SleepWorkers/Project-SIGHT/README.md

# Introduction
This repository is created for the purpose of participation in [IICDC 2018](https://innovate.mygov.in/india-innovation-challenge-design-contest-2018/) (India Innovation Challenge Design Contest). The project details _in short_ are summarized below:

|||
| ----- | --- |
|**Project Name** | Project _SIGHT_ (Smart Infinity Glove using Heuristic Technology) - Transforming the way we live |
|**Submission ID** | 372888 |

# Table of contents
- [Introduction](#introduction)
- [Table of contents](#table-of-contents)
  - [About Project](#about-project)
- [Cloning this project](#cloning-this-project)
  - [Users](#users)
  - [Developers](#developers)
    - [Ubuntu users](#ubuntu-users)
    - [MacOS or Windows users](#macos-or-windows-users)
- [Folder information](#folder-information)
  - [Visible folders](#visible-folders)
  - [Hidden folders](#hidden-folders)

## About Project
This project is created for the purpose of participation in [IICDC 2018](https://innovate.mygov.in/india-innovation-challenge-design-contest-2018/) (India Innovation Challenge Design Contest).

The human hand is the most versatile part of the body. We exploit its dexterity to provide a glove that can transcend today’s wearables by giving an organic feel while interacting with technology. We feel today,the most important and difficult to procure resources are time, money, health & safety. S.I.G.H.T. will safeguard these resources.

We've used the following operating systems in the development of this project. Note that not all operating systems might support all packages of the project.
  - [Ubuntu Xenial](http://releases.ubuntu.com/16.04/)
  - [MacOS Mojave](https://www.apple.com/in/macos/mojave/)

The project proposal file can be found [here](./.media/docs/372888_IICDC\ Proposal.pdf).

# Cloning this project
If you're looking to contribute, you're a developer. If you're looking to only use the product, you're a user.
## Users
To clone (download) the project, you can simply click on the **Clone or Download** button in the top right and download the entire project as a ZIP file.
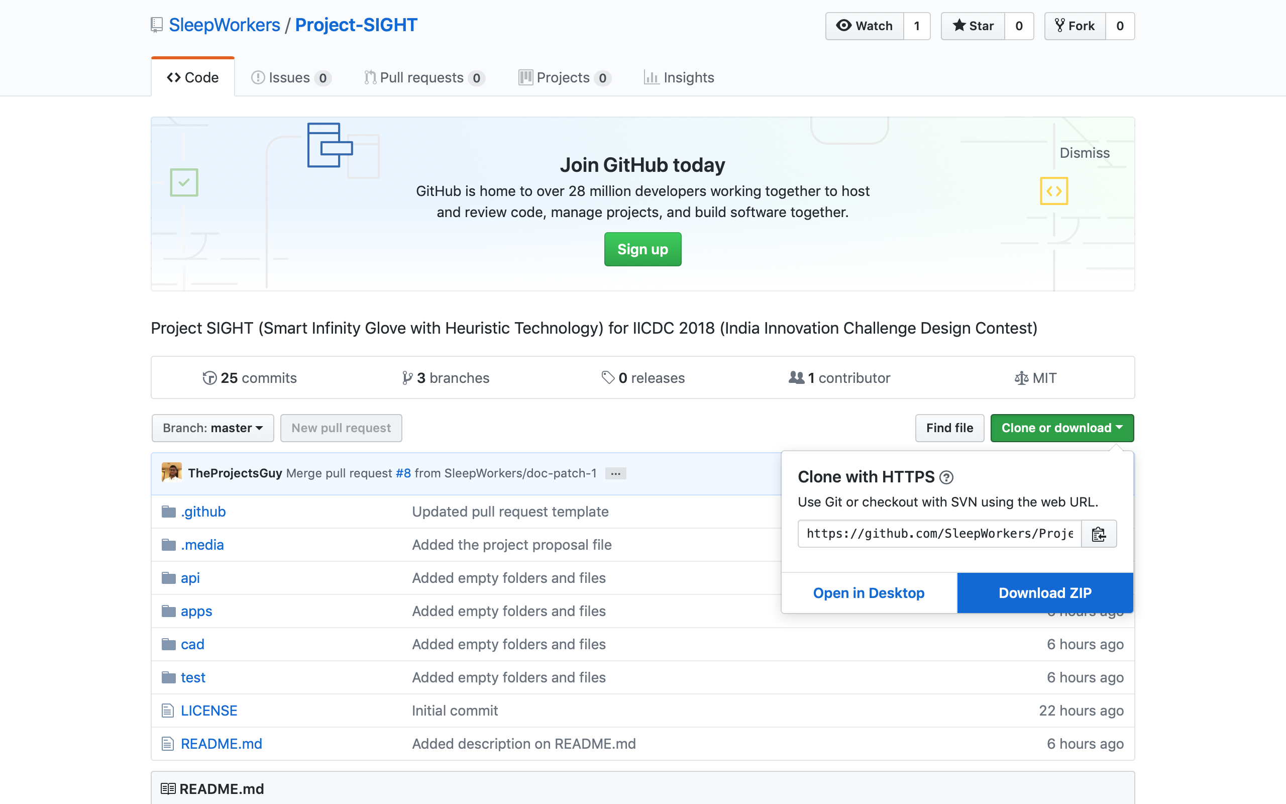
[picture p1: .media/photos/Download-project-ZIP.png]
Download as ZIP


## Developers
Before getting started, please go through the [contributing](./.github/CONTRIBUTING.md) guidelines.
You're suggested to clone this repository using the [git](https://git-scm.com/) tool which you can download [here](https://git-scm.com/downloads).
> **Tip**: Clone using [SSH](https://help.github.com/articles/connecting-to-github-with-ssh/) is a better idea.

### Ubuntu users
Open a terminal and do the following:
- _Install_ git
    ```bash
    sudo apt install git
    ```
- _cd_ into the directory where you want to clone
    ```bash
    cd ~
    ```
- _Clone_ the repository
  - Using SSH
    ```bash
    git clone git@github.com:SleepWorkers/Project-SIGHT.git
    ```
  - Using HTTPS
    ```bash
    git clone https://github.com/SleepWorkers/Project-SIGHT.git
    ```

### MacOS or Windows users
1. Install [GitHub Desktop](https://desktop.github.com) app.
2. Clone the repository (`File` -> `Clone Repository`) using the URL of this repository (https://github.com/SleepWorkers/Project-SIGHT.git) into a desired location.

You can use the GitHub Desktop app for all version control and project management purposes.

# Folder information
Here are the folders available in this project

## Visible folders

|||
|-----|-----|
|**test** | Files used during the testing phase |
|**cad**  | CAD files (Electrical and mechanical) |
|**api**  | Final APIs of the product |
|**apps** | Final applications for the product |

## Hidden folders
|||
|-----|-----|
|**.github**| All GitHub related documents.|
|**.media**| Media files used for documentation purposes in the present working directory.|
