SleepWorkers/Project-SIGHT/cad/README.md

# What is this ?
All the CAD files related to the SIGHT Project are stored in this folder.

# Table of Contents
- [What is this ?](#what-is-this)
- [Table of Contents](#table-of-contents)
