SleepWorkers/Project-SIGHT/(list of files, cad)

Other CAD files:
test/avneesh_test_files/TI_CC3220SF_WiFi_MCU/CCSv8_examples/I2CTest/tirtos_builds_CC3220SF_LAUNCHXL_release_ccs/src/sysbios/m3_IntrinsicsSupport_asm.obj
test/avneesh_test_files/TI_CC3220SF_WiFi_MCU/CCSv8_examples/I2CTest/tirtos_builds_CC3220SF_LAUNCHXL_release_ccs/src/sysbios/m3_TaskSupport_asm.obj
test/avneesh_test_files/TI_CC3220SF_WiFi_MCU/CCSv8_examples/I2CTest/tirtos_builds_CC3220SF_LAUNCHXL_release_ccs/src/sysbios/m3_Hwi_asm_switch.obj
test/avneesh_test_files/TI_CC3220SF_WiFi_MCU/CCSv8_examples/I2CTest/tirtos_builds_CC3220SF_LAUNCHXL_release_ccs/src/sysbios/m3_Hwi_asm.obj
test/avneesh_test_files/TI_CC3220SF_WiFi_MCU/CCSv8_examples/I2CTest/tirtos_builds_CC3220SF_LAUNCHXL_release_ccs/src/sysbios/BIOS.obj
