SleepWorkers/Project-SIGHT/test/avneesh_test_files/README.md

# What is this?
This is the testing scratchpad of @TheProjectsGuy (Avneesh Mishra). All codes written here are just for testing purposes, once they're ready, they're moved into appropriate directories.

# Table of contents
- [What is this?](#what-is-this)
- [Table of contents](#table-of-contents)
- [Folders](#folders)

# Folders
Here's information about the folders present in this directory

| **Folder Name** | **Purpose** |
| ---- | ---- |
| [*cv_algo*](./cv_algo/) | All Computer vision related codes |
| [*TI_CC3220SF_WiFi_MCU*](./TI_CC3220SF_WiFi_MCU/) | All the codes related only to CC3220SF Launch XL |
| [*Eagle_CAD*](./Eagle_CAD/) | Eagle CAD files |
| [*Arduino_codes*](/Arduino_codes/) | Arduino test codes (just if you need an alternative) |
| [*MATLAB_scripts*](./MATLAB_scripts/) | MATLAB Script files used |
| [*APIs*](./APIs/) | The APIs created while testing |

[][TheProjectsGuy-dev-profile]

[TheProjectsGuy-dev-shield]: https://img.shields.io/badge/Dev-TheProjectsGuy-0061ff.svg
[TheProjectsGuy-dev-profile]: https://github.com/TheProjectsGuy
