SleepWorkers/Project-SIGHT/test/DeviceTests/README.md

# What is this ?
This directory contains all the test files created for testing individual devices. 

# Table of contents
- [What is this ?](#what-is-this)
- [Table of contents](#table-of-contents)
- [Devices tested](#devices-tested)
  - [Pulse Sensor](#pulse-sensor)

# Devices tested
We've used and tested the following devices for this project

## Pulse Sensor
The pulse sensor is used to detect pulse rate. The entire sensor documentation can be found on [pulsesensor.com](https://pulsesensor.com/).

We've created the following codes for testing purposes

| **Code name** | **Purpose** |
| ----- | --- |
| [AnalogOutputSerial](./AnalogOutputSerial/) | To inspect the output of the sensor on the serial monitor |
