SleepWorkers/Project-SIGHT/test/avneesh_test_files/Eagle_CAD/README.md

# What is this?
This folder contains CAD files for [issue 15](https://github.com/SleepWorkers/Project-SIGHT/issues/15).

# Table of contents
- [What is this?](#what-is-this)
- [Table of contents](#table-of-contents)
- [Files and folders](#files-and-folders)
  - [Flex CV interface v1](#flex-cv-interface-v1)
  - [Flex connections](#flex-connections)
  - [Flex sensor circuits](#flex-sensor-circuits)

# Files and folders
## [Flex CV interface v1](./Flex_CV_interface_v1)
This folder contains files for the testing of the computer vision circuitry and the data collection algorithm part of [this issue](https://github.com/SleepWorkers/Project-SIGHT/issues/22). The files that are used for this are:

| **File Name** | **Purpose** |
| ---- | ---- |
| [*LED_connections.sch*](./Flex_CV_interface_v1/LED_connections.sch) | The LED connections to be made. Check Figure 1 (below) |

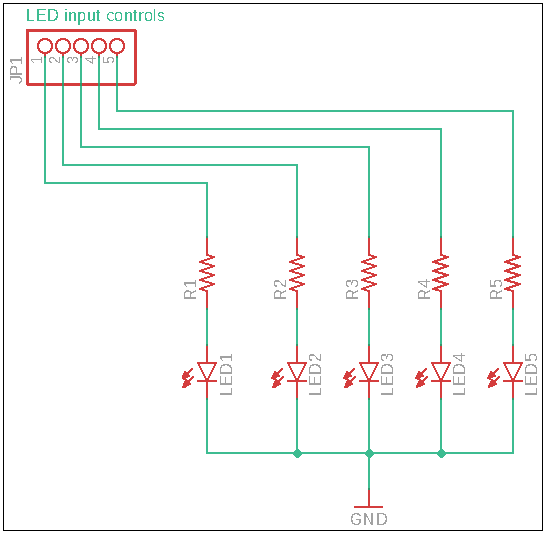
[picture p7: test/avneesh_test_files/.media/photos/LED_connections.png]
Figure 1: LED Connections to be made


**Figure 1**: The LED connections to be made.

## [Flex connections](./Flex_connections/)
The flex sensor connections for the circuit. This is aligned with the API to generate the circuitry.

| **File Name** | **Purpose** |
| ---- | ---- |
| [Final_circuit.sch](./Flex_connections/Final_circuit.sch) | The final circuitry (template) |

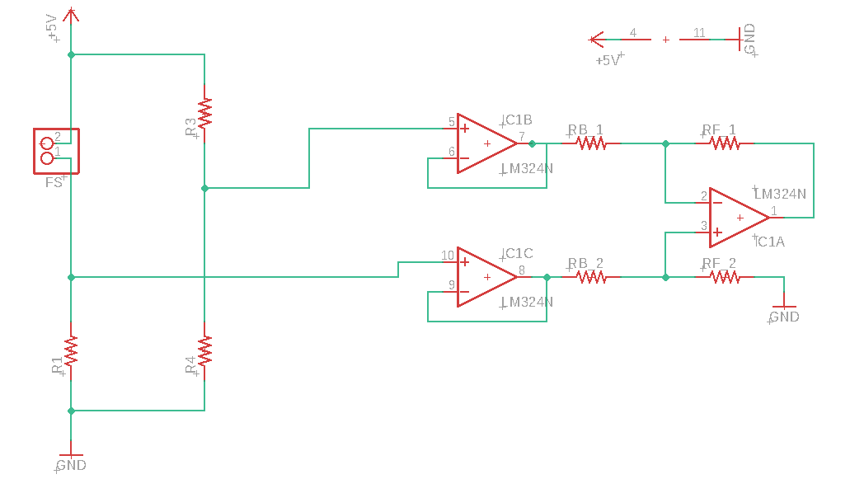
[picture p8: test/avneesh_test_files/APIs/.media/photos/Flex_sensor_final_eagle_1.png]
Final circuitry


## [Flex sensor circuits](./Flex_sensor_circuits/)
The individual flex sensor circuits for the connections. This is the final file having all the connection details.

[][TheProjectsGuy-dev-profile]
[][issue-link]

[TheProjectsGuy-dev-shield]: https://img.shields.io/badge/Dev-TheProjectsGuy-0061ff.svg
[TheProjectsGuy-dev-profile]: https://github.com/TheProjectsGuy
[issue-shield]: https://img.shields.io/badge/Issue-%2315-f49842.svg
[issue-link]: https://github.com/SleepWorkers/Project-SIGHT/issues/15
