SleepWorkers/Project-SIGHT/test/avneesh_test_files/APIs/README.md

# What is this?
This is the test folder for APIs developed by [TheProjectsGuy][TheProjectsGuy-dev-profile]

# Table of contents
- [What is this?](#what-is-this)
- [Table of contents](#table-of-contents)
- [Flex sensors](#flex-sensors)
  - [Circuit API](#circuit-api)

# Flex sensors
All the APIs concerned to the flex sensors are listed below:

| **API Name** | **Purpose** | **Platforms** |
| ----- | ----- | ----- |
| [Flex sensor circuit API][flex_sensor_circuit_api] | To generate circuit for flex sensors | MATLAB |

[flex_sensor_circuit_api]: ./Flex_sensor_circuitry/

## Circuit API
This API helps you pick the best set of resistors from the set that you have for the flex sensor circuitry.

[][TheProjectsGuy-dev-profile]

[TheProjectsGuy-dev-shield]: https://img.shields.io/badge/Dev-TheProjectsGuy-0061ff.svg
[TheProjectsGuy-dev-profile]: https://github.com/TheProjectsGuy
