SleepWorkers/Project-SIGHT/test/avneesh_test_files/Arduino_codes/README.md

# What is this?
This directory is to store the files tested on the Arduino platform.

# Table of contents
- [What is this?](#what-is-this)
- [Table of contents](#table-of-contents)
- [Files](#files)

# Files
The files are as follows:

| **File Name** | **Comment** |
| ---- | ---- |
| [*Analog_val_lock.ino*](./Analog_val_lock/Analog_val_lock.ino) | To transmit only an ADC reading over serial |
| [*LED_voltage_generator.ino*](./LED_voltage_generator/LED_voltage_generator.ino) | To generate different voltage levels for LEDs |
| [*Full_code.ino*](./Full_code/Full_code.ino) | The final code to be uploaded to the microcontroller for **data capturing session** |

[][TheProjectsGuy-dev-profile]

[TheProjectsGuy-dev-shield]: https://img.shields.io/badge/Dev-TheProjectsGuy-0061ff.svg
[TheProjectsGuy-dev-profile]: https://github.com/TheProjectsGuy
