SleepWorkers/Project-SIGHT/test/avneesh_test_phase1/MATLAB_tests_version2/README.md

# What is this ?
All MATLAB test files in version 2 are stored in this directory

# Table of contents
- [What is this ?](#what-is-this)
- [Table of contents](#table-of-contents)
- [Dependencies](#dependencies)
- [Folders and files](#folders-and-files)
  - [Script Files](#script-files)
    - [Flex Sensor](#flex-sensor)
  - [Simulink Files](#simulink-files)
    - [Flex Sensor](#flex-sensor-1)
      - [2.2 Inch](#22-inch)
      - [4.5 Inch](#45-inch)

# Dependencies
These tests have used the following MATLAB dependencies.

| **Package Name** | **Purpose** | **Link** |
| ---- | ---- | ---- |
| MATLAB | The core MATLAB package | [here](https://in.mathworks.com/products/matlab.html) |
| Simulink | For simulation purposes | [here](https://in.mathworks.com/products/simulink.html) |
| Simscape | For simulation of electronic circuits | [here](https://in.mathworks.com/products/simscape.html) |
| Simscape Electrical | Electrical simulation | [here](https://in.mathworks.com/products/simscape-electrical.html) |

# Folders and files
Information about all the folders is present below

## [Script Files](./Script_files/)
All the script files for testing are written here

### Flex Sensor
- [Flex_sensor_debug.m](./Script_files/Flex_sensor_debug.m): Debugger code written for flex sensor circuit generation. It can predict what are the resistance values to be used for the circuit under the optimal solution. The output is in text, stored in the file [output_flex_sensor_debug.txt](./Script_files/output_flex_sensor_debug.txt).
- [output_flex_sensor_debug.txt](./Script_files/output_flex_sensor_debug.txt): Output of the code in [Flex_sensor_debug.m](./Script_files/Flex_sensor_debug.m). This is obtained by running the following command in MATLAB command window (pwd is the [Script_files](./Script_files/) folder):
    ```bash
    run Flex_sensor_debug.m
    ```
- [Flex_full_debug_v1.m](./Script_files/Flex_full_debug_v1.m): The second version of the circuit generator. Give it resistance ranges and it'll given you everything about the circuit.
- [Final_flex_calculator.m](./Script_files/Final_flex_calculator.m): The final file for flex sensor testing.

The data that we used for testing is stored as `.mat` files in the [Backups](/Script_files/Backups/) folder.

## [Simulink Files](./Simulink/)
All [Simulink](https://www.mathworks.com/products/simulink.html) files are present below:

### Flex Sensor
#### 2.2 Inch
- [FlexSensor_2in2_v1.slx](./Simulink/FlexSensor_2in2_v1.slx): File created to showcase the results obtained from the [Flex_sensor_debug.m](./Script_files/Flex_sensor_debug.m) script (till the voltage divider analysis part) for the 2.2 inch flex sensor circuitry. 
  - Results match what the script had predicted
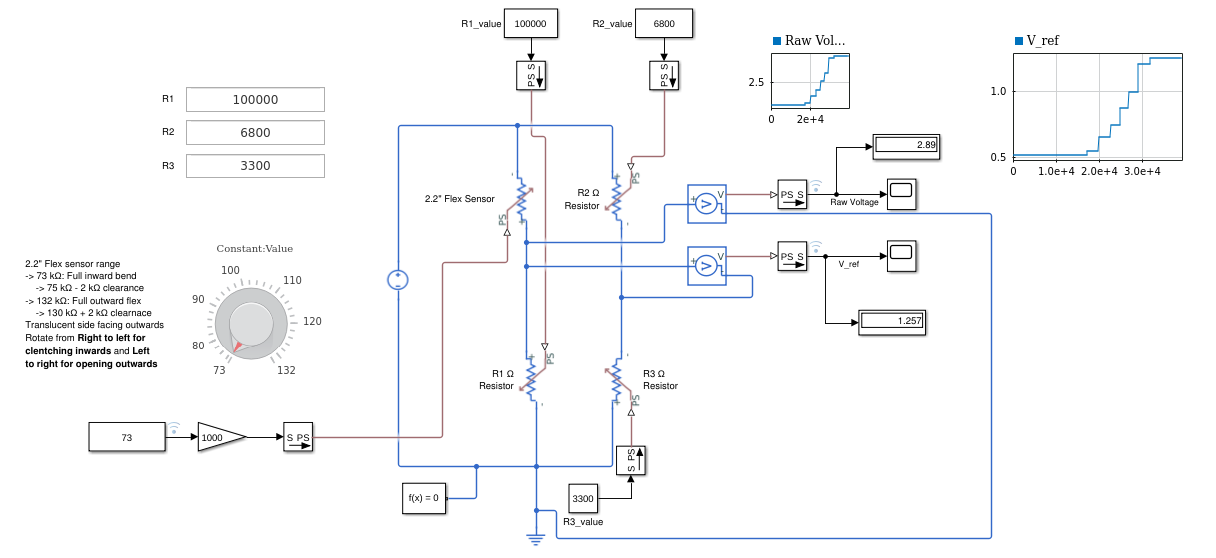
[picture p9: test/avneesh_test_phase1/.media/photos/Version21_FlexSensor_2in2_wheatstone.png]
2.2 inch wheatstone bridge version
    
    - Wheatstone bridge approach used
    - Not the best result
- [FlexSensor_2in2_v2.slx](./Simulink/FlexSensor_2in2_v2.slx): File created to showcase the results obtained from the [Flex_sensor_debug.m](./Script_files/Flex_sensor_debug.m) script for the 2.2 inch flex sensor circuitry. 
  - Results match what the script had predicted
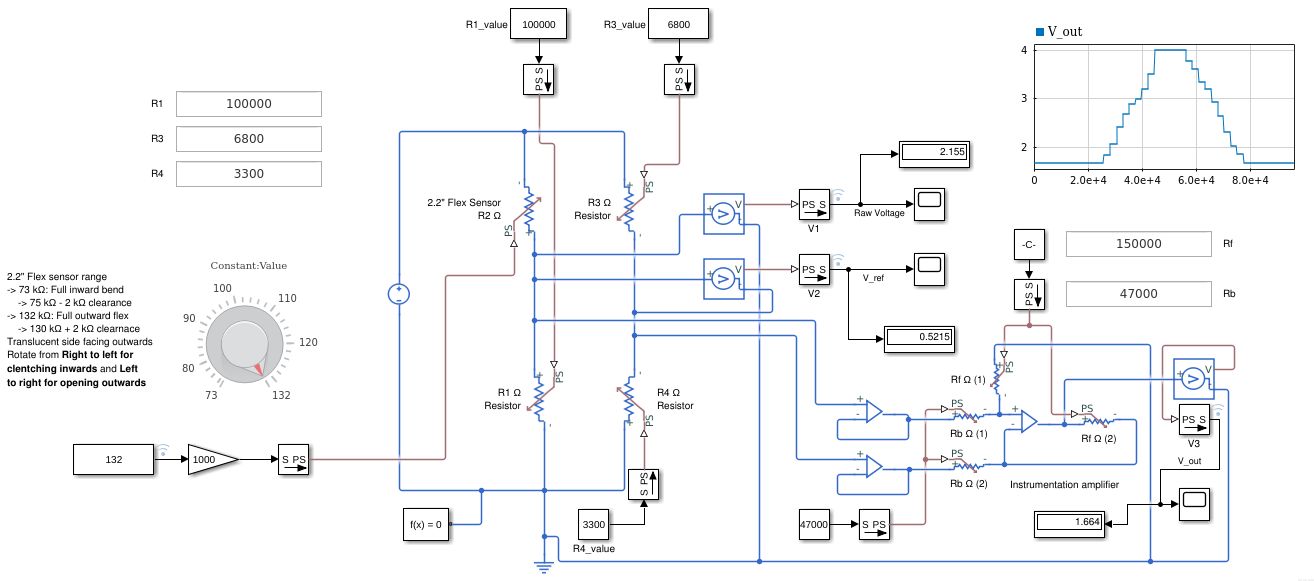
[picture p10: test/avneesh_test_phase1/.media/photos/Version22_FlexSensor_2in2_wheatstone.png]
2.2 inch op-amp version
    
    - Op-Amp implementation (instrumentation amplifier)
    - Updated with the [Final_flex_calculator.m](./Script_files/Final_flex_calculator.m)
    - Final circuitry for the 2.2 inch flex sensor

#### 4.5 Inch
- [FlexSensor_4in5_v1.slx](./Script_files/FlexSensor_4in5_v1.slx): File created to showcase the results obtained from the [Flex_sensor_debug.m](./Script_files/Flex_sensor_debug.m) script (till the voltage divider analysis part) for the 4.5 inch flex sensor circuitry. 
  - Results matched with the script
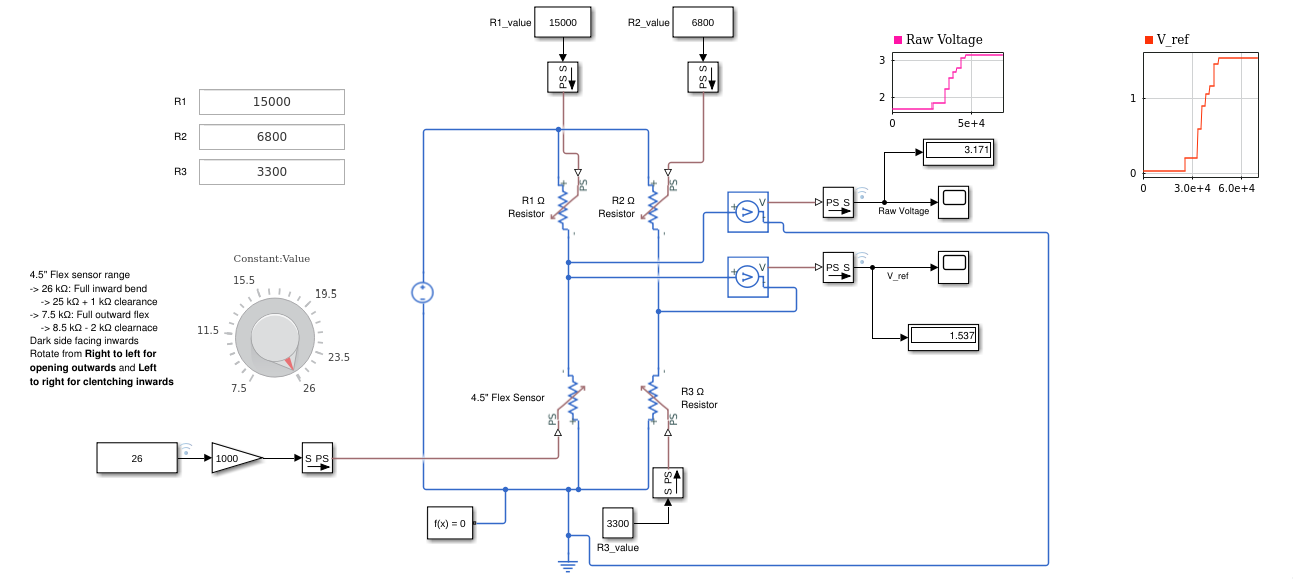
[picture p11: test/avneesh_test_phase1/.media/photos/Version21_FlexSensor_4in5_wheatstone.png]
4.5 inch wheatstone bridge version
    
    - Wheatstone bridge approach used
    - Not the best result
- [FlexSensor_4in5_v2.slx](./Simulink/FlexSensor_4in5_v2.slx): File created to showcase the results obtained from the [Flex_sensor_debug.m](./Script_files/Flex_sensor_debug.m) script for the 4.5 inch flex sensor circuitry. 
  - Results match what the script had predicted
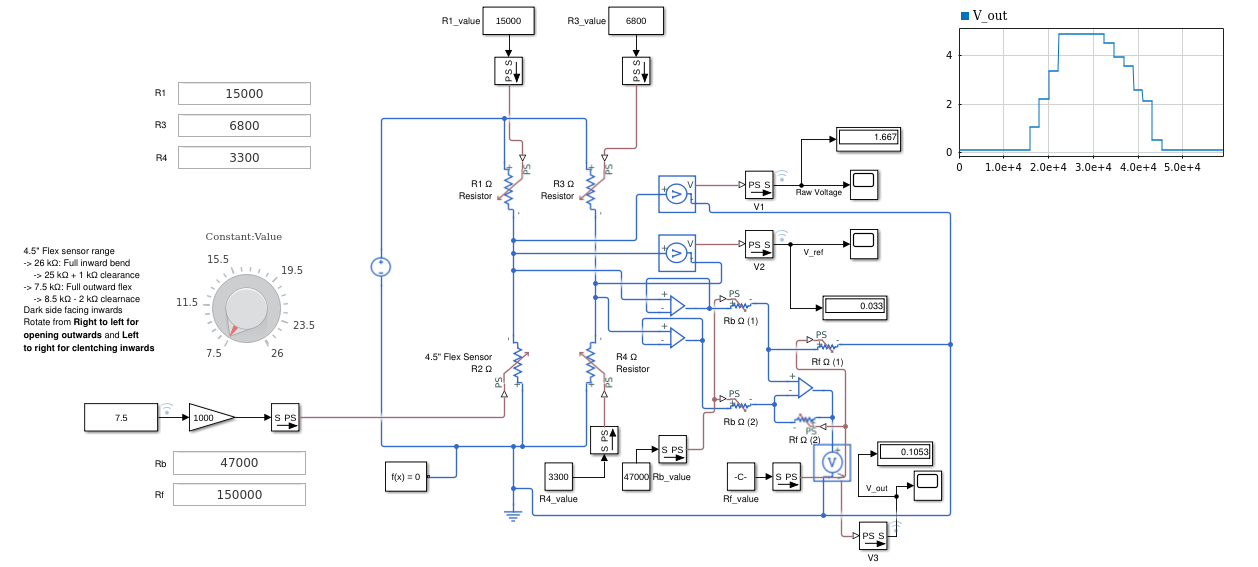
[picture p12: test/avneesh_test_phase1/.media/photos/Version22_FlexSensor_4in5_wheatstone.png]
4.5 inch op-amp version
    
    - Op-Amp implementation (instrumentation amplifier)
    - Updated with the [Final_flex_calculator.m](./Script_files/Final_flex_calculator.m)
    - Final circuitry for the 4.5 inch flex sensor

[][dev_profile]
[][issue_link]

[dev_shield]:https://img.shields.io/badge/Dev-TheProjectsGuy-0061ff.svg
[dev_profile]:https://github.com/TheProjectsGuy
[issue_shield]:https://img.shields.io/badge/issue-%2316-f49842.svg
[issue_link]:https://github.com/SleepWorkers/Project-SIGHT/issues/16
