SleepWorkers/Project-SIGHT/test/README.md

# What is this ?
This folder is for the stuff that we create _only_ for testing purposes

# Table of Contents
- [What is this ?](#what-is-this)
- [Table of Contents](#table-of-contents)
- [Directories](#directories)
  - [Individual test directories](#individual-test-directories)

# Directories
The directory structure in this folder are as follows

| **Directory name** | **Purpose** |
| ---- | ---- |
| [DeviceTests](./DeviceTests/) | For testing of individual devices (components) used in the project |

Additionally, there are the following directories present:
- [Individual test](#individual-test-directories) directories.

## Individual test directories
We performed a few tests individually, these are placed in dedicated folders for every developer. The directory list is as follows

| **Directory name** | **Purpose** |
| ---- | ----- |
[avneesh_test_phase1](./avneesh_test_phase1/) | Test codes written by @[TheProjectsGuy](https://github.com/TheProjectsGuy) |
