SleepWorkers/Project-SIGHT/test/avneesh_test_files/MATLAB_scripts/README.md

# What is this?
This is the directory for all the MATLAB script files under the parent directory

# Table of contents
- [What is this?](#what-is-this)
- [Table of contents](#table-of-contents)
- [Files](#files)

# Files
The important files are as follows:

| **File Name** | **Comments** |
| ---- | ---- |
| [*Final\_flex\_calculator.m*](./Final_flex_calculator.m) | This file is the exact copy of the file in test\_phase\_1. In fact, it maintains a hard link to the file |

[][TheProjectsGuy-dev-profile]

[TheProjectsGuy-dev-shield]: https://img.shields.io/badge/Dev-TheProjectsGuy-0061ff.svg
[TheProjectsGuy-dev-profile]: https://github.com/TheProjectsGuy
