SleepWorkers/Project-SIGHT/test/avneesh_test_files/cv_algo/Camera_tools/images/captured_image2.jpg

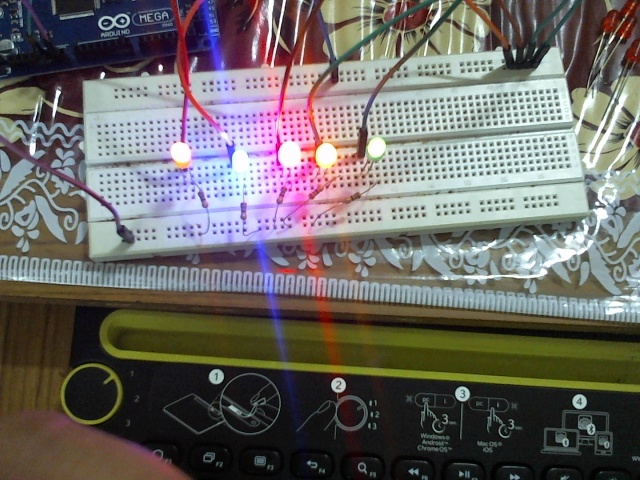
test/avneesh_test_files/cv_algo/Camera_tools/images/captured_image2.jpg
