SleepWorkers/Project-SIGHT/test/avneesh_test_phase1/.media/photos/Simscape_Final_Circuit.png

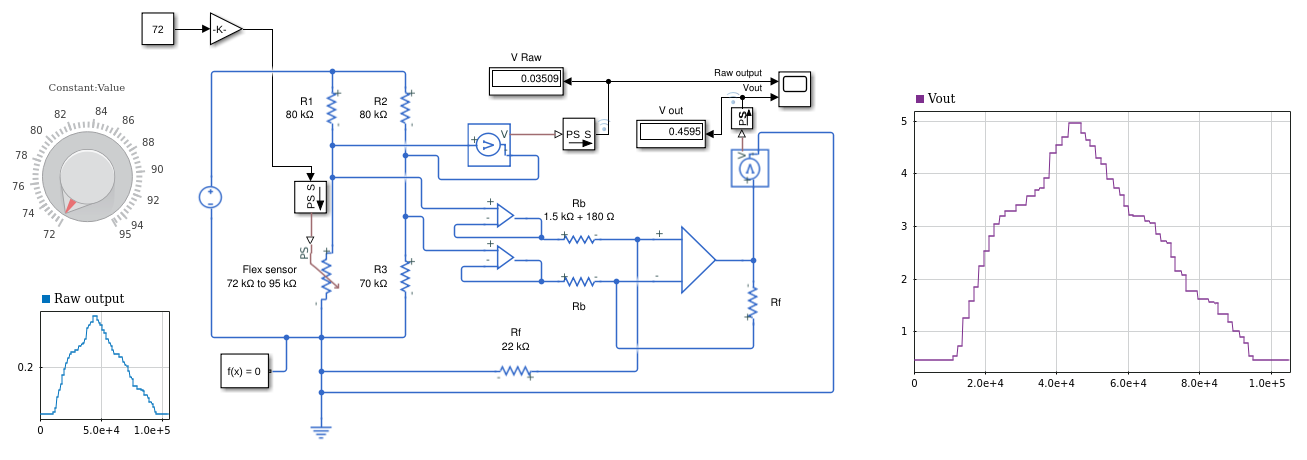
test/avneesh_test_phase1/.media/photos/Simscape_Final_Circuit.png
