SleepWorkers/Project-SIGHT/test/avneesh_test_phase1/.media/photos/Simulink_final_output_graphs.png

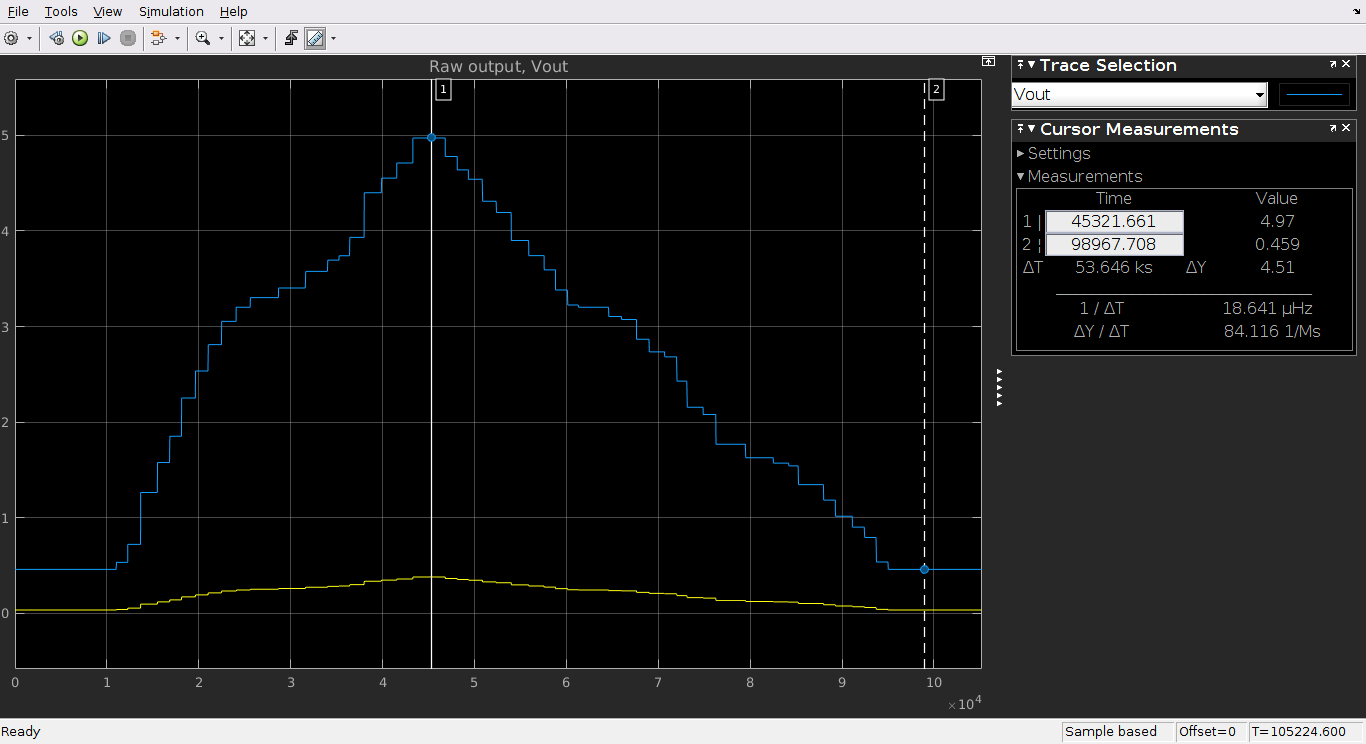
test/avneesh_test_phase1/.media/photos/Simulink_final_output_graphs.png
