SleepWorkers/Project-SIGHT/(threads)

Thread 12 (2019-01-07):

Testing phase - Part 1 (Avneesh)

TheProjectsGuy, 2019-01-07:
**Task priority**: HIGH

# Task description
Testing components (non-TI) till the TI components get delivered. Get the basic framework ready, the system diagram is needed.

**Person assigned**: @TheProjectsGuy
**Deadline**: Till TI components get delivered or _1<sup>st</sup> Februrary 2019_
**Branch name**: avneesh-test-phase1

**Pending Non-TI items to buy**
- [ ] MPU 9250 or another appropriate IMU with 9+ DoF
- [ ] Flex sensor 4.5" length for longer sensors

## Things that need to be done before parts arrive
- [ ] Algorithm for flex sensor for all five fingers
    - [ ] 2.2" for thumb and 4.5" for others
- [ ] Algorithm for IMU
- [ ] Algorithm for pulse sensor

# Must Haves
 - [ ] System Diagram
    - [ ] Connection between parts for the prototype stage (with arduino mega)
- [ ] Algorithm for pose estimation of the fingers
    - [ ] Pose of thumb with respect to palm (2.2" flex sensor)
    - [ ] Pose of other fingers with respect to palm (4.5" flex sensor)
        - [ ] Index
        - [ ] Middle
        - [ ] Ring
        - [ ] Little
- [ ] IMU working and transofrmations
    - [ ] IMU + transformation to finger joints
- [ ] Get BPM

## Extras
- [ ] API if there is time

TheProjectsGuy, 2019-01-17:
Started SIMULINK circuit diagram for bridge connections

TheProjectsGuy, 2019-02-01:
Issue outdated, closing it and creating a new one

Closed 2019-02-01.

Thread 13 (2019-01-07):

Testing phase - Part 1 (Bharath)

bharath0404, 2019-01-07:
**Task priority**: HIGH

# Task description
Testing components (non-TI) till the TI components get delivered. Get the basic framework ready, the system diagram is needed.

**Person assigned**: @bharath0404
**Deadline**: Till TI components get delivered or _1<sup>st</sup> Februrary 2019_
**Branch name**: bharath-test-phase1

**Pending Non-TI items to buy**
- [ ] MPU 9250 or another appropriate IMU with 9+ DoF
- [ ] Flex sensor 4.5" length for longer sensors

## Things that need to be done before parts arrive
- [ ] Algorithm for flex sensor for all five fingers
    - [ ] 2.2" for thumb and 4.5" for others
- [ ] Algorithm for IMU
- [ ] Algorithm for pulse sensor

# Must Haves
 - [ ] System Diagram
    - [ ] Connection between parts for the prototype stage (with arduino mega)
- [ ] Algorithm for pose estimation of the fingers
    - [ ] Pose of thumb with respect to palm (2.2" flex sensor)
    - [ ] Pose of other fingers with respect to palm (4.5" flex sensor)
        - [ ] Index
        - [ ] Middle
        - [ ] Ring
        - [ ] Little
- [ ] IMU working and transofrmations
    - [ ] IMU + transformation to finger joints
- [ ] Get BPM

## Extras
- [ ] API if there is time

Closed 2019-02-06.

Thread 14 (2019-01-07):

Testing Phase - Part 1 (Vibhu)

supaboi21, 2019-01-07:
**Task priority**: HIGH

# Task description
Testing components (non-TI) till the TI components get delivered. Get the basic framework ready, the system diagram is needed.

**Person assigned**: @supaboi21
**Deadline**: Till TI components get delivered or _1<sup>st</sup> Februrary 2019_
**Branch name**: supaboi21

**Pending Non-TI items to buy**
- [x] MPU 9250 or another appropriate IMU with 9+ DoF
- [x] Flex sensor 4.5" length for longer sensors

## Things that need to be done before parts arrive
- [ ] Algorithm for flex sensor for all five fingers
    - [ ] 2.2" for thumb and 4.5" for others
- [ ] Algorithm for IMU
- [ ] Algorithm for pulse sensor

# Must Haves
 - [ ] System Diagram
    - [ ] Connection between parts for the prototype stage (with arduino mega)
- [ ] Algorithm for pose estimation of the fingers
    - [ ] Pose of thumb with respect to palm (2.2" flex sensor)
    - [ ] Pose of other fingers with respect to palm (4.5" flex sensor)
        - [ ] Index
        - [ ] Middle
        - [ ] Ring
        - [ ] Little
- [ ] IMU working and transformations
    - [ ] IMU + transformation to finger joints
- [ ] Get BPM

## Extras
- [ ] API if there is time

Closed 2019-02-04.

Thread 15 (2019-02-01):

Main task list for @TheProjectsGuy

TheProjectsGuy, 2019-02-01:
**Task priority**: HIGH

# Task description
Given the flex sensors, figure out an algorithm for finding joint angles from the stress values of the flex sensor. Pointwise needs are as follows:
- Making a full-fledged API for the Flex Sensor

**Person assigned**: [@TheProjectsGuy](https://github.com/TheProjectsGuy)

**Deadline**: Monday, 11<sup>th</sup> February 2019

# Procedural steps
## Step 1: Simulation
Get a simulation up and running, giving useful values as proof of concept.
- [ ] MATLAB Simulink Simulation
    - [ ] Find the correct values of variables to be used
- [ ] Import to other versions and documentation
- [ ] Shift changes to `dev` branch through a _pull request_

## Step 2: Simple setup
### Electrical circuitry
- [ ] Make a CAD file with reference to the simulation circuit (preferably in eagle)
- [ ] Build up the circuitry on a breadboard
- [ ] Test with Arduino Mega

### Computer vision part
We'll use LEDs to find angles. Use CV to get joint angles while simultaneously recording the flex sensor readings
- [ ] Make a CAD file for the LED connections (voltage divider circuitry)
- [ ] OpenCV Algorithm
    - [ ] Hunt for the best algorithm that fits the purpose
    - [ ] Test algorithm with LEDs arranged in a fashion through a laptop webcam
    - [ ] Test on a web camera
- [ ] Python script
    - [ ] Arduino (Reading the flex sensor values)
    - [ ] OpenCV code
    - [ ] Implement both in a class-wise fashion and use synchronized multithreading to handle both, see if output comes on console
- [ ] Store everything in a numpy database for training algorithm

## Step 3: Algorithm
- [ ] Figure out an algorithm for converting the stress values into joint angles

## Step 4: Frame visualization
- [ ] Visualize frames on a visualization platform

# Extras
**Priority**: LOW
Here are some extra things that can be implemented, if time permits:
- [ ] Implementation in C++ (C++ API)
- [ ] Phone side application for
    - [ ] iOS
    - [ ] Android
- [ ] Computer side application for
    - [ ] Ubuntu
    - [ ] MacOS

TheProjectsGuy, 2019-02-01:
# Step 1
Simulation done
## Materials required
- [ ] Flex sensor 2.2''
- [ ] Resistors
    - For instrumentation amplifier
        - [ ] 1.5 kΩ resistors (x 2)
        - [ ] 180 Ω resistors (x 2)
        - [ ] 22 kΩ resistors (x 2)
    - For the wheatstone bridge
        - [ ] 80 kΩ resistors (x 2) for the upper arms
        - [ ] 70 kΩ resistor (x 1) for the reference arm (lower resistor)
- [ ] Op-Amps (x 3) for the instrumentation amplifier construction
- [ ] Breadboard and jumper wires
- [ ] Arduino and multimeter for programming and debugging

Thread 16 (2019-02-01):

Simulation of Flex sensor circuitry

TheProjectsGuy, 2019-02-01:
**Task priority**: HIGH

# Task description
Simulation of Flex sensor circuitry on MATLAB.
References issue #15 (Main task list for @TheProjectsGuy)

**Person assigned**: [@TheProjectsGuy](https://github.com/TheProjectsGuy)

**Deadline**: Sunday, 5<sup>th</sup> February 2019

# Must Haves
Get a simulation up and running, giving useful values as proof of concept.
- [x] MATLAB Simulink Simulation
    - [x] Find the correct values of variables to be used
- [ ] Import to other versions (R2016a) and documentation
- [x] Shift changes to `dev` branch through a _pull request_

## Extras
Things that could be worked on after the _must haves_ are finished.
- [ ] Interactive mode to change all the values and see things easily

Attach all results to this issue as well, for documentation purposes

TheProjectsGuy, 2019-02-01:
Tests done on the **2.2'' flex sensor**
## MATLAB Trial 1
Edited the default configurations for the flex sensor and stored in the file `Flex_Sensor_final_circuitry.slx`. The default values for resistors was decided to be 1.5 kΩ + 180 Ω for input and 22 kΩ for feedback. The results are as follows:
- Circuit design in simulation
    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
- The output designs are as follows
    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
        - *Vout*: Output voltage of instrumentation amplifier: 0.459 V to 4.97 V (difference of **4.51 V**)
        - *Raw output*: Output of voltage divider (wheatstone bridge): 0.0351 V to 0.38 V (difference of **0.345 V**)
        - Amplification factor = 13.095

## Parts needed
### Circuitry
- [ ] Flex sensor 2.2''
- [ ] Resistors
    - For instrumentation amplifier
        - [ ] 1.5 kΩ resistors (x 2)
        - [ ] 180 Ω resistors (x 2)
        - [ ] 22 kΩ resistors (x 2)
    - For the wheatstone bridge
        - [ ] 80 kΩ resistors (x 2) for the upper arms
        - [ ] 70 kΩ resistor (x 1) for the reference arm (lower resistor)
- [ ] Op-Amps (x 3) for the instrumentation amplifier construction
- [ ] Breadboard and jumper wires
- [ ] Arduino and multimeter for programming and debugging

TheProjectsGuy, 2019-02-01:
Simulation solved

TheProjectsGuy, 2019-02-03:
The resistance values will have to be tweaked because of limited availability, the available resistors are as shown below
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
Suggested to make modifications ASAP

TheProjectsGuy, 2019-02-05:
## Flex Sensor testing
| **Flex Sensor length** | **Finger**(s) | **Resistance at full inward bend** | **Resistance at full outward flex** | **Comments** |
| :----: | :----: | ---- | ---- | ---- |
| `2.2in` | Thumb | 75 kΩ | 130 kΩ | Flex sensor has to be used with translucent side facing outwards, hence values are reversed. Suggested to change the position on wheatstone bridge |
| `4.5in` | All four 3 joint fingers | 25 kΩ | 8.5 kΩ | Flex sensor has to be used with black line facing inwards. Suggested to maintain the position on the wheatstone bridge |

Since the flex sensor readings are different, the resistance values will **have** to be tweaked along with a factor of safety (to avoid _out of bounds cases_). It's suggested to use:
- 1 kΩ factor of safety for `4.5in` flex sensors
- 2 kΩ factor of safety for `2.2in` flex sensors

Thus, the ranges are:
- `2.2in`: 73 kΩ to 132 kΩ.
- `4.5in`: 26 kΩ to 7.5 kΩ

These will keep everything in bound... Task list:
- [ ] Voltage divider network for both the flex sensors
- [ ] Determine the constant reference voltage arm to be used for the wheatstone bridge
- [ ] New resistance values to be found
- [ ] Documentation update

TheProjectsGuy, 2019-02-08:
Remaining task list:
## CAD Files
Using Eagle, create the following CAD files
- [ ] CAD for 2.2" flex sensor
- [ ] CAD for 4.5" flex sensor
- [ ] CAD for entire hand using the analog MUX

TheProjectsGuy, 2019-02-16:
Issue solved on Saturday, 16<sup>th</sup> February 2019. Proceeding to the next issue in hand

Closed 2019-02-16.

Thread 18 (2019-02-04):

IMU Configuration for Pose Estimation

supaboi21, 2019-02-04:
**Task priority**: HIGH

# Task description
Write Algorithm for IMU [LSM9DS1](https://www.sparkfun.com/products/13284) \(Pose Estimation\)

**Person assigned**: [@supaboi21](https://github.com/supaboi21)

**Deadline**: 13<sup>th</sup> February 2019

# Procedure (Step by Step)
## Step 1: Datasheet Lookup
### Deadline: 6<sup>th</sup> February 2019
- [ ] LSM9DS1
    - [ ] Connections (Arduino | MSP430)
- [ ] MSP430FR2355

## Step 2: Coding
### Deadline: 12<sup>th</sup> February 2019
- [ ] Paper/Code Hunting
- [ ] Implementation

## Step 3: Debugging
### Deadline: 13<sup>th</sup> February 2019
- [ ] Debugging
# Must Haves
- [ ] Output neccessary output over which Gesture Recognition will work

## Extras
- [ ] Integration with #15 for Gesture Recognition

supaboi21, 2019-02-20:
This Issue is Modified and will be ccarried on there.

Closed 2019-02-20.

Thread 19 (2019-02-06):

Testing_Pulse_Sensor

bharath0404, 2019-02-06:
**Task priority**: (HIGH)

# Task description
To implement an API for the pulse sensor applications using Simplelink CC2640 Bluetooth wireless MCU.

**Person assigned**: Bharath04

**Deadline**:  Saturday, 9 Feb 2019

# Must-Haves
- Program to detect the pulse rate and compute BPM.
- Implement the noise-free functionality of the pulse sensor.
- Research on strokes and their effect on BPM.
- Research on calorie count algorithms based on BPM and thus develop various activity trackers.

## Extras

Closed 2019-02-26.

Thread 21 (2019-02-17):

Subgoals for @TheProjectsGuy

TheProjectsGuy, 2019-02-17:
**Task priority**: HIGH

# Task description
The interim submission deadline is approaching and you need to finish the tasks under _Must Haves_. It is also suggested that you finish the tasks under _Extras_.
This issue spawns from #15

**Person assigned**: Task assigned to @TheProjectsGuy

**Deadline**: Thursday, 21<sup>st</sup> March 2019

# Must Haves
## Before getting started
Here are the things that you have to do:
- [x] Review and test everything that you've on the `dev` branch, do the following:
    - [x] Individual tests.
    - [x] Move everything that's working into appropriate folders and everything that's not working into the `Project-SIGHT/test/contrib/avneesh_tests_v1/` folder.
    - [x] Documentation work
    - [x] Merge into `master` with a _pull request_.
- [x] Create a branch `avneesh-dev-1` for the development process (from the dev branch). Everything happens in the `test` folder.
Actual process starts from hereon...
:warning: Everything handled in folder `avneesh_test_files` on branch `avneesh-test-pahse1` :warning:

## Algorithm
- [x] Develop code to read analog readings from the flex sensor
    - Make code as generic as possible, because of ADCs having different precision
    - Can be on Arduino as well
- [ ] Using OpenCV, make an algorithm to find angles
    - You'll use it for joint angles
    - [x] CAD for LED circuitry
    - [ ] Procure a webcam
- [ ] Python script to collect training examples
    - Synchronous multithreading: for the CV and ADC readings over serial
- [ ] Collect training examples for the training, cross validation and test set
    - [ ] Create a dataset with joint angles as output and stress voltage as input
- [ ] Train algorithm
- [ ] Final test of the algorithm, without the CV verification part
    - Test for consistency and reliability
- [ ] Port the weights and model architecture into code for microcontroller(s)
    - Arduino and TI CCS (or Energia)

## Flex Sensors
All this on breadboard
- [x] Final code to interface flex sensors to Arduino using analog mux
- [x] Final code to interface flex sensors to TI SimpleLink CC3220SF WiFi MCU
    - [x] TI SimpleLink CC3220SF WiFi MCU quick start. All codes in folder named `test/ti_cc3220sf/`.
        - [x] Digital I/O
        - [x] Timers, delays, etc.
        - [x] ADCs
        - [x] Serial communication
    - [x] Single Flex sensor (without the analog mux) code
    - [x] Multiple Flex sensor code (using the analog mux)
    - Everything should be visible on a terminal

All this on a veroboard (port from breadboard)
- [ ] Eagle board design
- [ ] Solder the board
    - [ ] Procure components
- [ ] Final test

## Extras
Things that could be worked on after the _must haves_ are finished.
- [ ] Python script to get values from terminal and display them onto a GUI like RViZ
    - This could be a good start to ROS API (but it's a long shot)
- [ ] Integration with various other frames
    - Native DH parameter API for first level developers

# References
- TI SimpleLink CC3220SF
    - [website](http://www.ti.com/tool/CC3220SF-LAUNCHXL)
    - datasheets in your drive
- OpenCV [documentation](https://docs.opencv.org)

TheProjectsGuy, 2019-02-17:
All CV based progress can be tracked under issue #22 or on branch `avneesh-test-cv`

TheProjectsGuy, 2019-02-21:
Chose the following for development:
    - [Energia](energia.nu/)
    - [CCS](http://www.ti.com/tool/CCSTUDIO)
    - [dev.ti.com](https://dev.ti.com/)

TheProjectsGuy, 2019-03-15:
Everything ported to trello

Closed 2019-03-15.

Thread 22 (2019-02-17):

Algorithm to determine joint angles

TheProjectsGuy, 2019-02-17:
**Task priority**: HIGH

# Task description
Design and implement an algorithm to measure angles using CV. You're given a chain of LEDs and you have to estimate the angle subtended at every LED in between. This will be used for the CV based training tool. You're free to decide how to store the data collected. This issue is a direct sub issue of #21

**Person assigned**: @TheProjectsGuy

**Deadline**: Saturday, 23<sup>rd</sup> February 2019

# Must Haves
## Before getting started
- [x] Create a branch `avneesh-test-cv` from `dev` and do all work in a folder named `Project-SIGHT/test/avneesh_test_files/cv_algo`

## Main work
### CAD
Your circuitry requires
- [x] Eagle CAD file for connections and layouts

### Arduino code
- [x] Code for Arduino

### Python code
Your Python code for detection must do the following
- [x] Get an image from a source containing
    - The image will have green LEDs. The chain order can be decided based upon their intensities.
- [ ] Create a mask for every intensity threshold
    - Localized histogram analysis can be used
    - The three joint fingers will have 5 chain LEDs and two joint fingers will have 4 chain LEDs
    - The ultimate result must be able to indicate the index of every member of chain
- [ ] Connect them using lines in a GUI window
- [ ] Find angles for every member of chain
    - Except the first and last member (because there are no angles subtended there)
- [x] Store the recorded angles in a numpy based `.npy` file

## Extras
- [ ] Synchronized multithreading (for now generate a random number in synchronous and store that too in the file

TheProjectsGuy, 2019-02-23:
The LED approach will fail at this stage since all LEDs give nearly the same brightness factor. Will have to go with hand labelling dataset. Will need to buy a few items as discussed on Slack group. We will need more resistor ranges, according to the MATLAB script.

TheProjectsGuy, 2019-02-24:
# Test 1
The effectiveness of the circuit that we build with the resistors we have is very less and the current in the sidearm of the Wheatstone bridge will be too high for the microcontroller.
**Results**
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
**Ideal** desired output
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

Suggested to buy the resistors pack

Needed the following:
- FCI 2 terminal connectors for flex sensors (3 will also work)
- Jumper wires for connecting LEDs more efficiently

TheProjectsGuy, 2019-03-07:
No image processing technique found useful, issue scrapped

Closed 2019-03-09.

Thread 23 (2019-02-20):

Output-RPY(IMU

supaboi21, 2019-02-20:
**Task priority**: HIGH

# Task description
Roll, Pitch and Yaw[RPY] from the IMU LSM9DS01, interfacing through MSP430FR2355.

**Person assigned**:  @supaboi21

**Deadline**: _Thursday, 21<sup>st</sup> February 2019_

# Must Haves
- IMU output in the form of RPY to MSP430FR2355

## Extras
- NA

Thread 24 (2019-02-20):

Output-RPY(IMU)

supaboi21, 2019-02-20:
**Task priority**: HIGH

# Task description
Roll, Pitch and Yaw[RPY] from the IMU LSM9DS01, interfacing through MSP430FR2355.

**Person assigned**:  @supaboi21

**Deadline**: _Thursday, 21<sup>st</sup> February 2019_

# Must Haves
- IMU output in the form of RPY to MSP430FR2355

## Extras
- NA

supaboi21, 2019-02-20:
Using [Cloud tools](https://dev.ti.com/) provided by TI. Using Energia Compiler.

supaboi21, 2019-02-27:
Only Arduino Mega Code was Completed

Closed 2019-02-27.

Thread 29 (2019-03-01):

Phase 1 - Interim - TheProjectsGuy

TheProjectsGuy, 2019-03-01:
**Task priority**: HIGH

# Task description
Getting to know your board `TI SimpleLink WiFi CC3220SF MCU`. You must learn all the basic driver features of your board and then proceed to phase 2 of the project. Spawns from issue #21

**Person assigned**: @TheProjectsGuy

**Deadline**: Sunday, 3<sup>rd</sup> March 2019

# Must Haves
Learn the following:
- [x] GPIO
    - [x] Writing values
    - [x] Reading values
    - [x] Interrupts
- [x] PWM Generated output (Analog Output)
- [x] Analog Input through ADCs
- [x] Basic communication protocols
    - [x] Serial
    - [ ] I2C
    - [x] SPI

## Extras
Things that could be worked on after the _must haves_ are finished.
- [ ] WiFi SDK readthrough

TheProjectsGuy, 2019-03-03:
Work happening on `avneesh-test-phase1`

Closed 2019-03-09.

Thread 31 (2019-03-09):

Flex sensor circuit generation tool API

TheProjectsGuy, 2019-03-09:
**Task priority**: HIGH

# Task description
An API that will help in generating circuit parameters for the flex sensor. The user must only input the flex sensor parameters and the program must output all the parameters in the console. For now, a MATLAB script would do. This issue is a direct subissue of #15

**Person assigned**: @TheProjectsGuy

**Deadline**: Saturday, 9<sup>th</sup> March 2019

# Must Haves
- [x] MATLAB script for predicting resistance values and other parameters
    - Make it as versatile as possible because it will probably have to make circuits for three different variants.
- [x] CAD files
- [x] Documentation
    - Methods to use the API
- After everything is done, move progress to dev branch, test and then move it to API folder.

Closed 2019-03-09.

Thread 33 (2019-03-10):

Create CV Data creation bridge

TheProjectsGuy, 2019-03-10:
**Task priority**: HIGH

# Task description
Create a data creation tool for the `flex sensor circuitry reading` Vs `joint angle` dataset.

**Person assigned**: @TheProjectsGuy

**Deadline**: Sunday, 10<sup>th</sup> March 2019

# Must Haves
- [ ] TI Board code
    - That will read from ADC based on a command received and send result
- Python end code
    - [ ] Serial parser
    - [ ] Snap image and save serial readings in a `.npy` file
    - [ ] Convert image to joint angles using selection tool. Then save joint angles Vs serial readings in a `.npy` file
        - This is the dataset

## Extras
Things that could be worked on after the _must haves_ are finished.
- Check out the algorithms for training
    - Neural Networks
    - Perceptron

TheProjectsGuy, 2019-03-11:
Everything done in `v1` folder of `cv_bridge`

TheProjectsGuy, 2019-03-11:
Code ready on `avneesh-dev-1` [branch](https://github.com/SleepWorkers/Project-SIGHT/tree/avneesh-dev-1). The solution is present in the [cv_bridge](https://github.com/SleepWorkers/Project-SIGHT/tree/avneesh-dev-1/test/avneesh_test_files/cv_bridge) folder.
