SleepWorkers/Project-SIGHT/test/avneesh_test_files/Eagle_CAD/Flex_sensor_circuits/Eagle/Wheatstone_bridge.brd

## EAGLE design test/avneesh_test_files/Eagle_CAD/Flex_sensor_circuits/Eagle/Wheatstone_bridge.brd (2019-03-20)

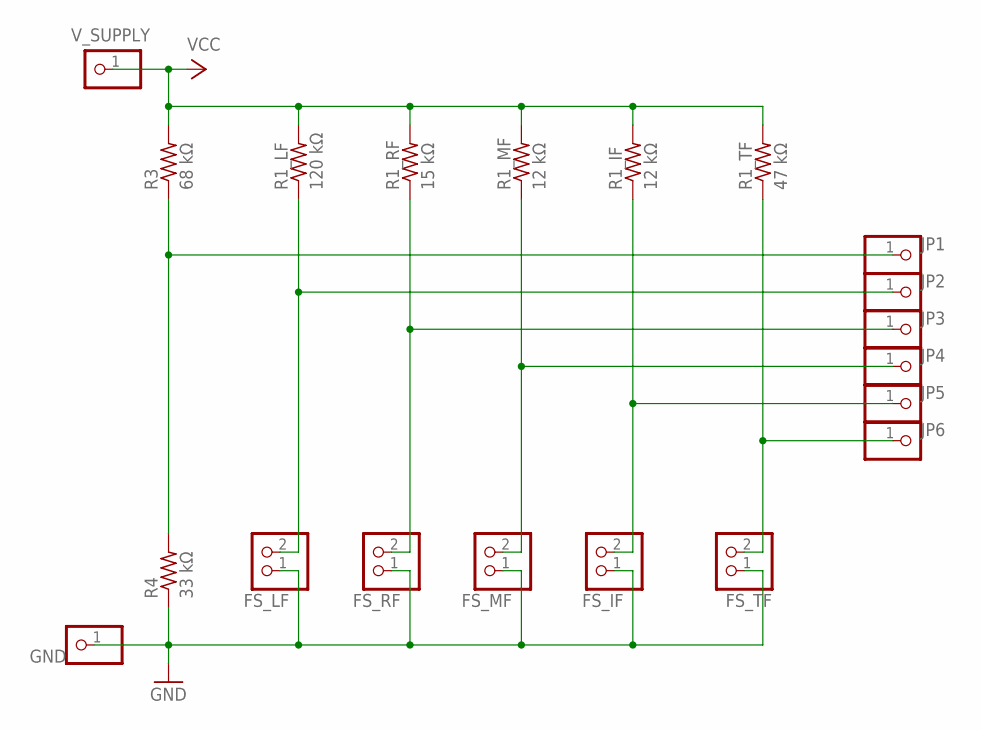
[picture p30: schematic Wheatstone_bridge.sch]

Parts:
FS_IF: PINHD-1X2; 1X02
FS_LF: PINHD-1X2; 1X02
FS_MF: PINHD-1X2; 1X02
FS_RF: PINHD-1X2; 1X02
FS_TF: PINHD-1X2; 1X02
GND: PINHD-1X1; 1X01
JP1, JP2, JP3, JP4, JP5, JP6: PINHD-1X1; 1X01
R1_IF, R1_MF: 12 kΩ; 0207/7
R1_LF: 120 kΩ; 0207/7
R1_RF: 15 kΩ; 0207/7
R1_TF: 47 kΩ; 0207/7
R3: 68 kΩ; 0207/7
R4: 33 kΩ; 0207/7
V_SUPPLY: PINHD-1X1; 1X01

Connections:
GND: FS_IF.1, FS_LF.1, FS_MF.1, FS_RF.1, FS_TF.1, GND.1, R4.1
unnamed: JP1.1, R3.1, R4.2
unnamed: FS_LF.2, JP2.1, R1_LF.1
unnamed: FS_TF.2, JP6.1, R1_TF.1
unnamed: FS_RF.2, JP3.1, R1_RF.1
unnamed: FS_MF.2, JP4.1, R1_MF.1
unnamed: FS_IF.2, JP5.1, R1_IF.1
VCC: R1_IF.2, R1_LF.2, R1_MF.2, R1_RF.2, R1_TF.2, R3.2, V_SUPPLY.1

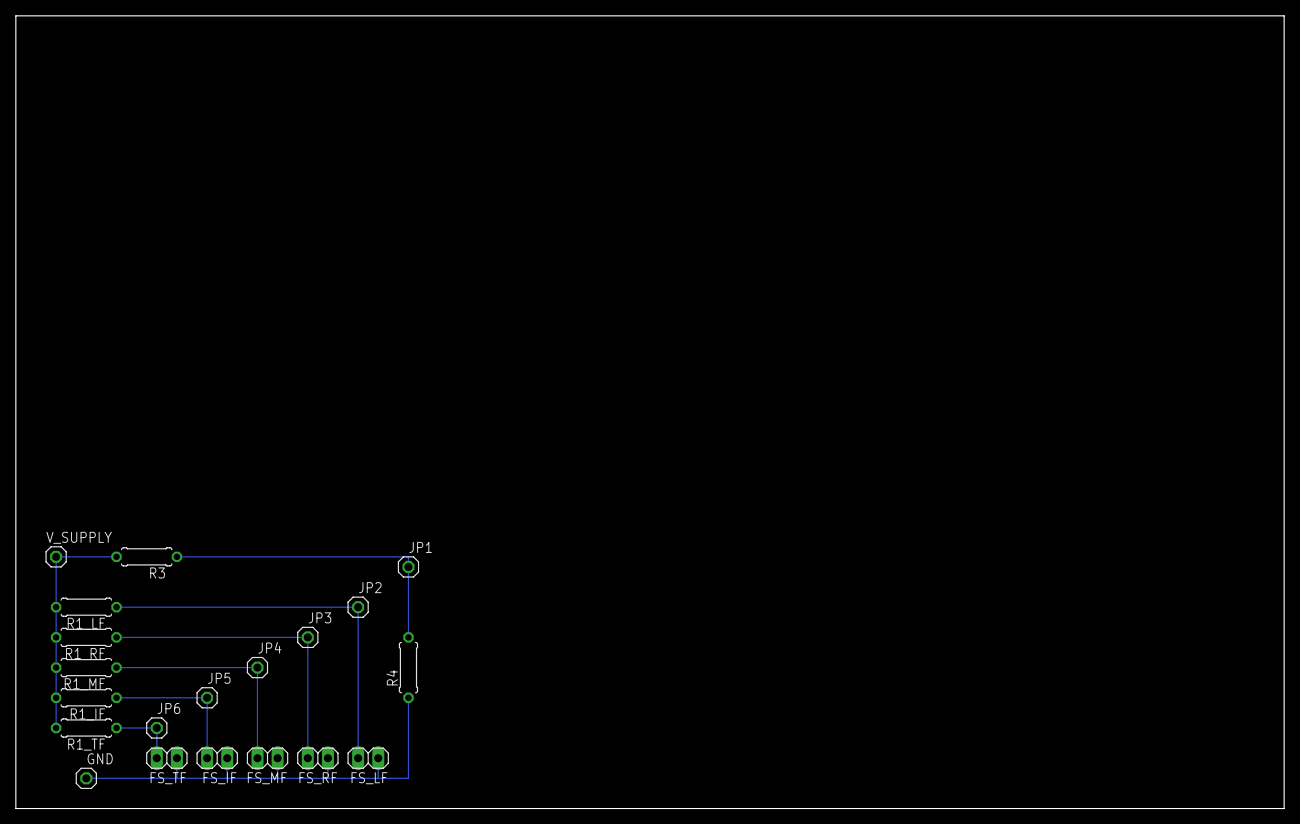
[picture p31: board Wheatstone_bridge.brd from above]

Board: 2 copper layers, 160.0 x 100.0 mm, 20 parts (0 on the bottom side), 8 nets.
