SleepWorkers/Project-SIGHT/test/avneesh_test_files/Eagle_CAD/Flex_sensor_circuits/Eagle/Instrumentation_amplifier_CC3220SF.brd

## EAGLE design test/avneesh_test_files/Eagle_CAD/Flex_sensor_circuits/Eagle/Instrumentation_amplifier_CC3220SF.brd (2019-03-20)

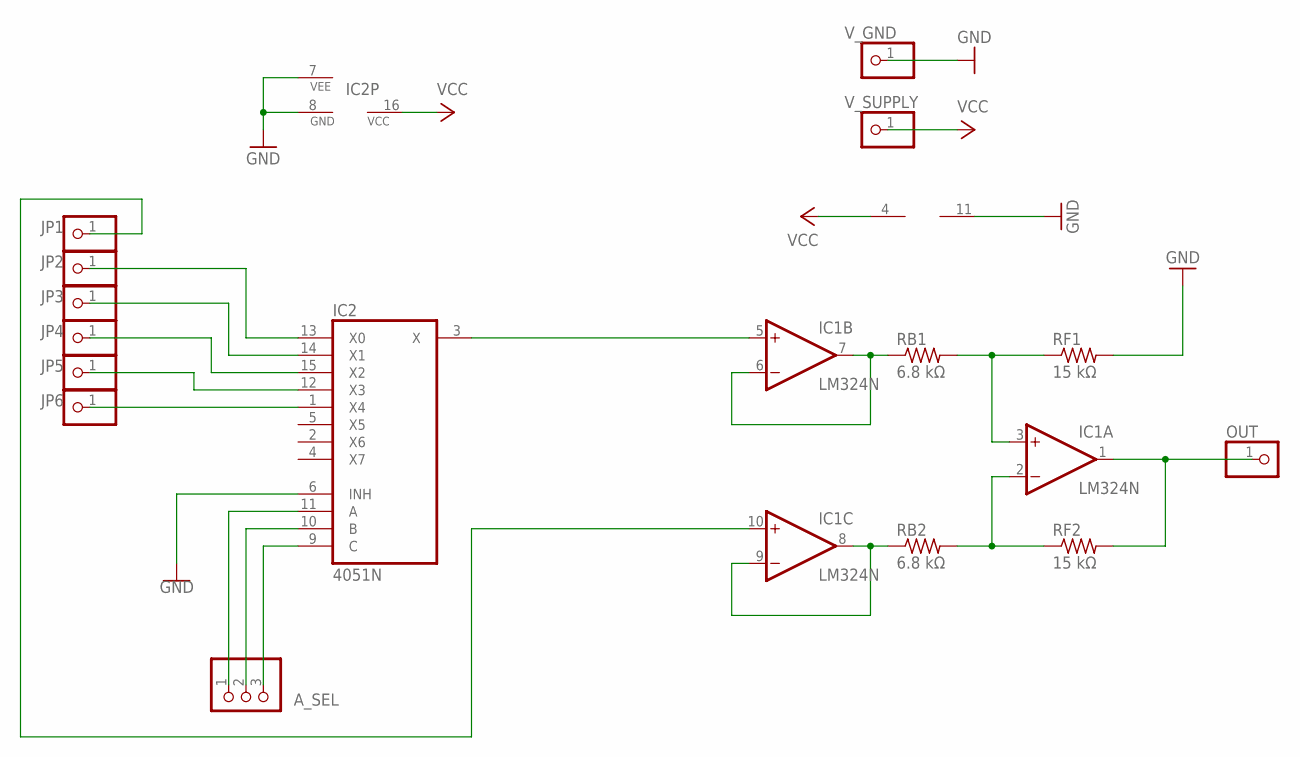
[picture p32: schematic Instrumentation_amplifier_CC3220SF.sch]

Parts:
A_SEL: PINHD-1X3; 1X03
IC1: LM324N; DIL14
IC2: 4051N; DIL16
JP1, JP2, JP3, JP4, JP5, JP6: PINHD-1X1; 1X01
OUT: PINHD-1X1; 1X01
RB1, RB2: 6.8 kΩ; 0204/7
RF1, RF2: 15 kΩ; 0204/7
V_GND: PINHD-1X1; 1X01
V_SUPPLY: PINHD-1X1; 1X01

Connections:
GND: IC1.11 (V-), IC2.6 (INH), IC2.7 (VEE), IC2.8 (GND), RF1.2, V_GND.1
unnamed: IC1.10 (+IN), JP1.1
unnamed: IC1.8 (OUT), IC1.9 (-IN), RB2.1
unnamed: IC1.2 (-IN), RB2.2, RF2.1
unnamed: IC1.6 (-IN), IC1.7 (OUT), RB1.1
unnamed: IC1.3 (+IN), RB1.2, RF1.1
unnamed: IC2.13 (X0), JP2.1
unnamed: IC1.5 (+IN), IC2.3 (X)
unnamed: IC2.14 (X1), JP3.1
unnamed: IC2.15 (X2), JP4.1
unnamed: IC1.1 (OUT), OUT.1, RF2.2
unnamed: IC2.12 (X3), JP5.1
unnamed: IC2.1 (X4), JP6.1
unnamed: A_SEL.1, IC2.11 (A)
unnamed: A_SEL.2, IC2.10 (B)
unnamed: A_SEL.3, IC2.9 (C)
VCC: IC1.4 (V+), IC2.16 (VCC), V_SUPPLY.1

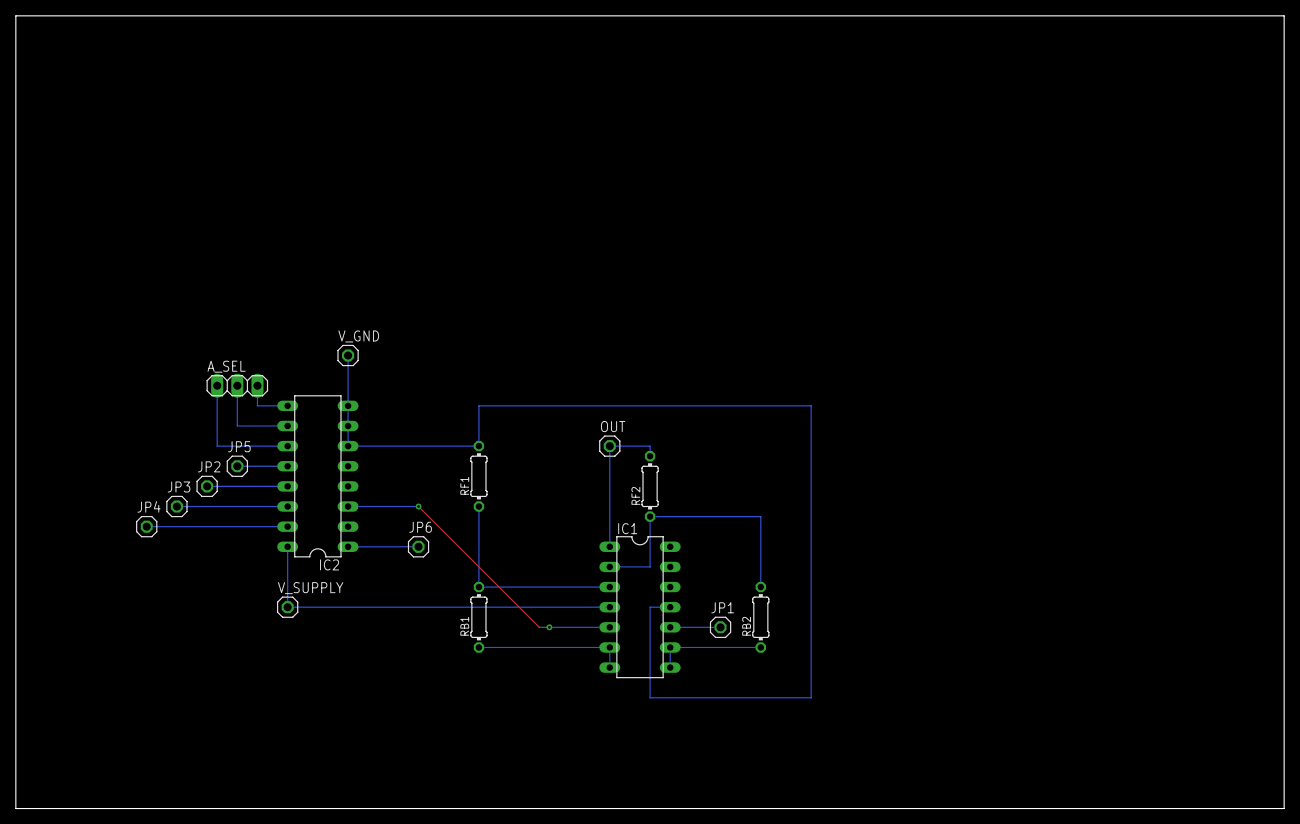
[picture p33: board Instrumentation_amplifier_CC3220SF.brd from above]

Board: 2 copper layers, 160.0 x 100.0 mm, 16 parts (0 on the bottom side), 17 nets.
