SleepWorkers/Project-SIGHT/test/avneesh_test_files/Eagle_CAD/Flex_CV_interface_v1/LED_connections.sch

## EAGLE design test/avneesh_test_files/Eagle_CAD/Flex_CV_interface_v1/LED_connections.sch (2019-03-09)

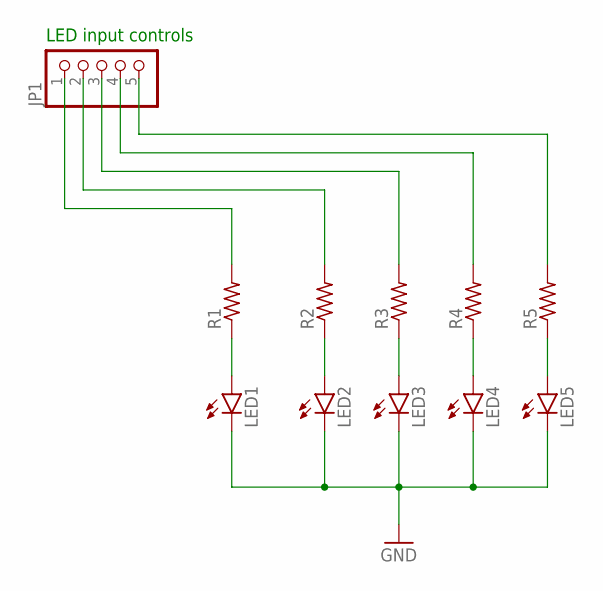
[picture p34: schematic LED_connections.sch]

Parts:
JP1: PINHD-1X5; 1X05
LED1, LED2, LED3, LED4, LED5: LED5MM
R1, R2, R3, R4, R5: R-US_0207/7; 0207/7

Connections:
GND: LED1.K (C), LED2.K (C), LED3.K (C), LED4.K (C), LED5.K (C)
unnamed: JP1.1, R1.2
unnamed: JP1.2, R2.2
unnamed: JP1.3, R3.2
unnamed: JP1.4, R4.2
unnamed: JP1.5, R5.2
unnamed: LED1.A, R1.1
unnamed: LED2.A, R2.1
unnamed: LED3.A, R3.1
unnamed: LED4.A, R4.1
unnamed: LED5.A, R5.1

Notes on the sheet:
LED input controls
