SleepWorkers/Project-SIGHT/test/avneesh_test_files/Eagle_CAD/Flex_connections/Final_circuit.sch

## EAGLE design test/avneesh_test_files/Eagle_CAD/Flex_connections/Final_circuit.sch (2019-03-09)

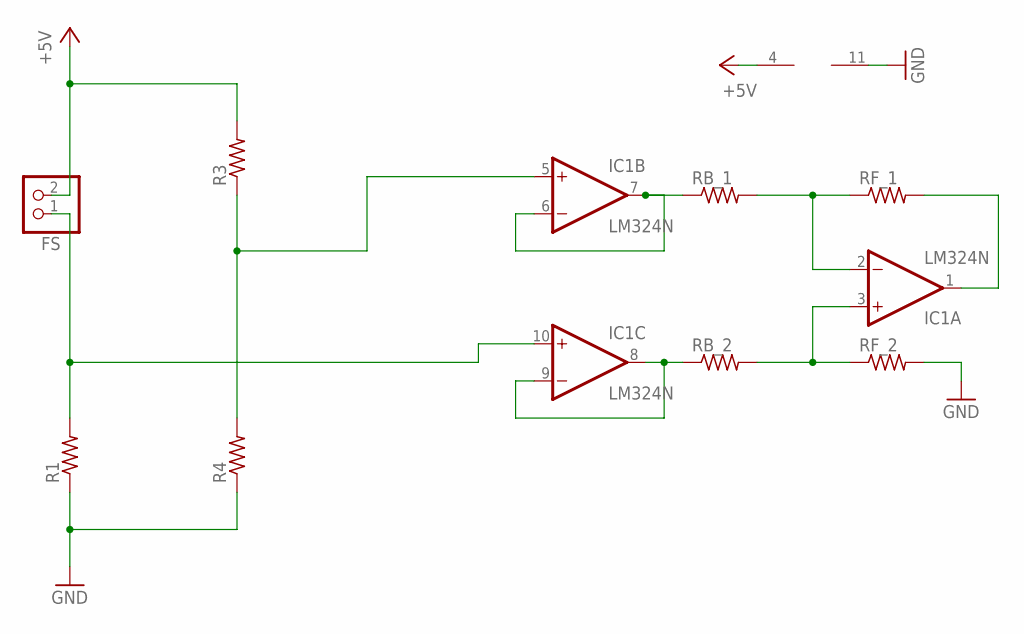
[picture p35: schematic Final_circuit.sch]

Parts:
FS: PINHD-1X2; 1X02
IC1: LM324N; DIL14
R1, R3, R4: R-US_0207/10; 0207/10
RB_1, RB_2: R-US_0207/10; 0207/10
RF_1, RF_2: R-US_0207/10; 0207/10

Connections:
+5V: FS.2, IC1.4 (V+), R3.2
GND: IC1.11 (V-), R1.1, R4.1, RF_2.2
unnamed: FS.1, IC1.10 (+IN), R1.2
unnamed: IC1.6 (-IN), IC1.7 (OUT), RB_1.1
unnamed: IC1.2 (-IN), RB_1.2, RF_1.1
unnamed: IC1.5 (+IN), R3.1, R4.2
unnamed: IC1.3 (+IN), RB_2.2, RF_2.1
unnamed: IC1.8 (OUT), IC1.9 (-IN), RB_2.1
unnamed: IC1.1 (OUT), RF_1.2
