SleepWorkers/Project-SIGHT/test/avneesh_test_files/Eagle_CAD/Flex_connections/flex_sensor_wheatstone.sch

## EAGLE design test/avneesh_test_files/Eagle_CAD/Flex_connections/flex_sensor_wheatstone.sch (2019-03-09)

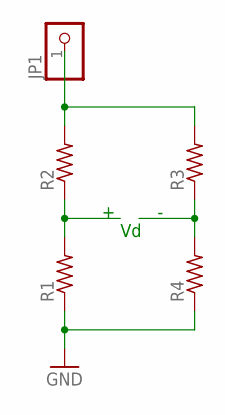
[picture p36: schematic flex_sensor_wheatstone.sch, sheet 1]

Parts:
JP1: PINHD-1X1; 1X01
R1, R2: R-US_0207/5V; 0207/5V
R3, R4: R-US_0207/7; 0207/7

Connections:
GND: R1.1, R4.1
unnamed: R1.2, R2.1
unnamed: R3.1, R4.2
unnamed: JP1.1, R2.2, R3.2
