SleepWorkers/Project-SIGHT/test/avneesh_test_files/Eagle_CAD/Flex_connections/flex_sensors_two_types.sch

## EAGLE design test/avneesh_test_files/Eagle_CAD/Flex_connections/flex_sensors_two_types.sch (2019-03-09)

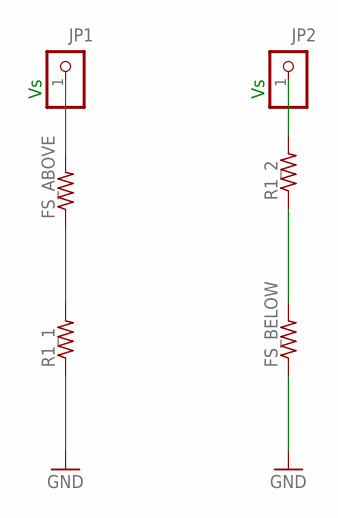
[picture p37: schematic flex_sensors_two_types.sch]

Parts:
FS_ABOVE: R-US_0207/5V; 0207/5V
FS_BELOW: R-US_0207/5V; 0207/5V
JP1, JP2: PINHD-1X1; 1X01
R1_1, R1_2: R-US_0207/5V; 0207/5V

Connections:
GND: FS_BELOW.1, R1_1.1
unnamed: FS_ABOVE.2, JP1.1
unnamed: FS_ABOVE.1, R1_1.2
unnamed: JP2.1, R1_2.2
unnamed: FS_BELOW.2, R1_2.1
