SleepWorkers/Project-SIGHT/test/avneesh_test_files/Eagle_CAD/Flex_connections/instrumentation_amplifier.sch

## EAGLE design test/avneesh_test_files/Eagle_CAD/Flex_connections/instrumentation_amplifier.sch (2019-03-09)

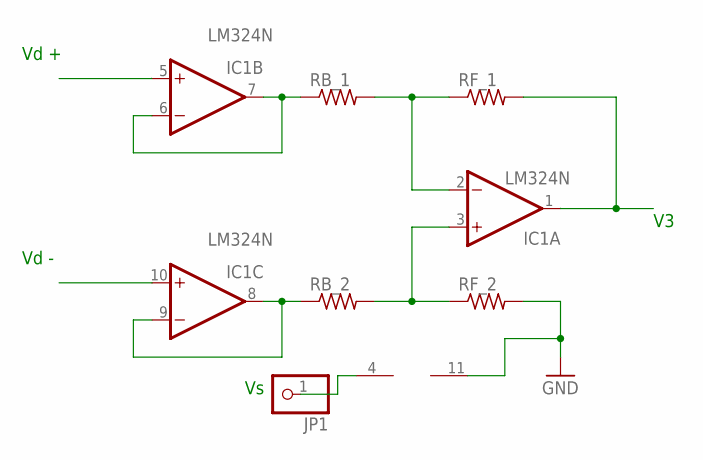
[picture p38: schematic instrumentation_amplifier.sch]

Parts:
IC1: LM324N; DIL14
JP1: PINHD-1X1; 1X01
RB_1, RB_2: R-US_0309/10; 0309/10
RF_1, RF_2: R-US_0309/10; 0309/10

Connections:
GND: IC1.11 (V-), RF_2.2
unnamed: IC1.4 (V+), JP1.1
unnamed: IC1.3 (+IN), RB_2.2, RF_2.1
unnamed: IC1.8 (OUT), IC1.9 (-IN), RB_2.1
unnamed: IC1.6 (-IN), IC1.7 (OUT), RB_1.1
unnamed: IC1.2 (-IN), RB_1.2, RF_1.1
unnamed: IC1.1 (OUT), RF_1.2

Notes on the sheet:
Vd +
Vd -
