SleepWorkers/Project-SIGHT/test/avneesh_test_phase1/Electronic_CAD_files/SIGHT/FlexSensor_v2/FlexSensor_v2/Final_circuitry_v1.sch

## EAGLE design test/avneesh_test_phase1/Electronic_CAD_files/SIGHT/FlexSensor_v2/FlexSensor_v2/Final_circuitry_v1.sch (2019-02-16)

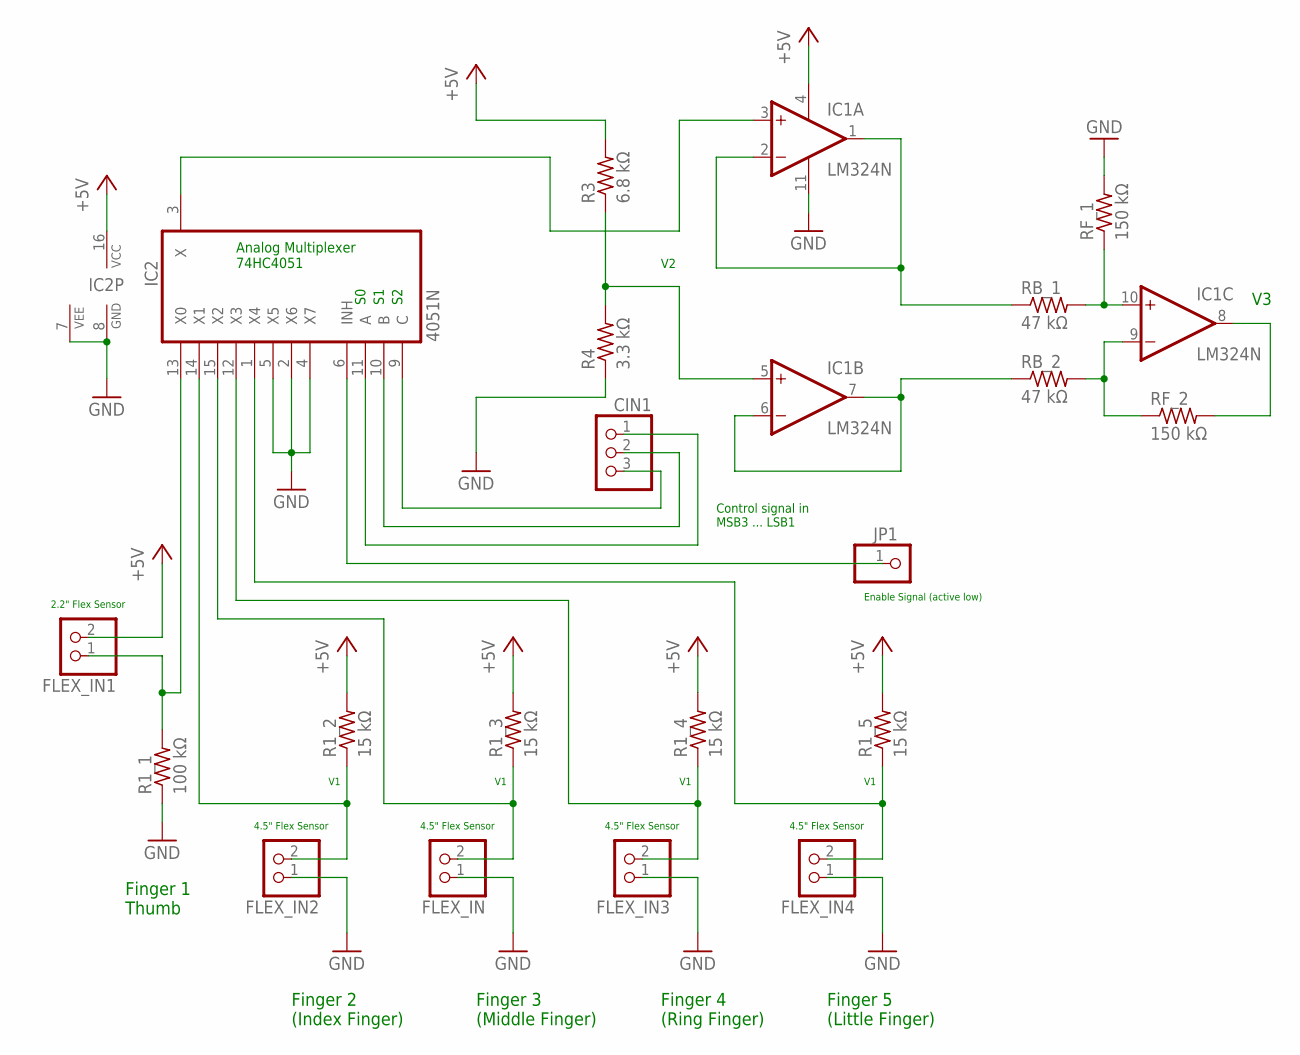
[picture p39: schematic Final_circuitry_v1.sch]

Parts:
CIN1: PINHD-1X3; 1X03
FLEX_IN, FLEX_IN1, FLEX_IN2, FLEX_IN3, FLEX_IN4: PINHD-1X2; 1X02
IC1: LM324N; DIL14
IC2: 4051N; DIL16
JP1: PINHD-1X1; 1X01
R1_1: 100 kΩ; 0204/5
R1_2, R1_3, R1_4, R1_5: 15 kΩ; 0204/5
R3: 6.8 kΩ; 0204/5
R4: 3.3 kΩ; 0204/5
RB_1, RB_2: 47 kΩ; 0204/5
RF_1, RF_2: 150 kΩ; 0204/5

Connections:
+5V: FLEX_IN1.2, IC1.4 (V+), IC2.16 (VCC), R1_2.2, R1_3.2, R1_4.2, R1_5.2, R3.2
GND: FLEX_IN.1, FLEX_IN2.1, FLEX_IN3.1, FLEX_IN4.1, IC1.11 (V-), IC2.2 (X6), IC2.4 (X7), IC2.5 (X5), IC2.7 (VEE), IC2.8 (GND), R1_1.1, R4.1, RF_1.2
unnamed: IC1.10 (+IN), RB_1.2, RF_1.1
unnamed: IC1.5 (+IN), R3.1, R4.2
unnamed: FLEX_IN.2, IC2.15 (X2), R1_3.1
unnamed: IC1.6 (-IN), IC1.7 (OUT), RB_2.1
unnamed: IC1.1 (OUT), IC1.2 (-IN), RB_1.1
unnamed: IC1.3 (+IN), IC2.3 (X)
unnamed: IC1.9 (-IN), RB_2.2, RF_2.1
unnamed: CIN1.1, IC2.11 (A)
unnamed: IC1.8 (OUT), RF_2.2
unnamed: FLEX_IN1.1, IC2.13 (X0), R1_1.2
unnamed: FLEX_IN2.2, IC2.14 (X1), R1_2.1
unnamed: CIN1.2, IC2.10 (B)
unnamed: FLEX_IN3.2, IC2.12 (X3), R1_4.1
unnamed: CIN1.3, IC2.9 (C)
unnamed: FLEX_IN4.2, IC2.1 (X4), R1_5.1
unnamed: IC2.6 (INH), JP1.1

Notes on the sheet:
4.5" Flex Sensor
2.2" Flex Sensor
Finger 1 Thumb
Finger 2 (Index Finger)
Finger 3 (Middle Finger)
Finger 4 (Ring Finger)
Finger 5 (Little Finger)
Control signal in MSB3 ... LSB1
Analog Multiplexer 74HC4051
Enable Signal (active low)
