SleepWorkers/Project-SIGHT/test/avneesh_test_phase1/Electronic_CAD_files/SIGHT/FlexSensor_v2/FlexSensor_v2/Simple_2in2_flex.sch

## EAGLE design test/avneesh_test_phase1/Electronic_CAD_files/SIGHT/FlexSensor_v2/FlexSensor_v2/Simple_2in2_flex.sch (2019-02-16)

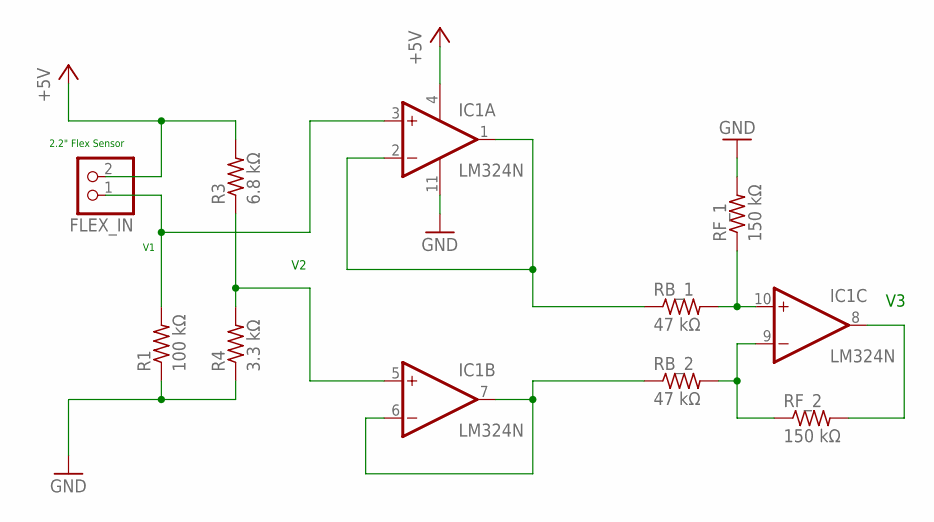
[picture p40: schematic Simple_2in2_flex.sch]

Parts:
FLEX_IN: PINHD-1X2; 1X02
IC1: LM324N; DIL14
R1: 100 kΩ; 0204/5
R3: 6.8 kΩ; 0204/5
R4: 3.3 kΩ; 0204/5
RB_1, RB_2: 47 kΩ; 0204/5
RF_1, RF_2: 150 kΩ; 0204/5

Connections:
+5V: FLEX_IN.2, IC1.4 (V+), R3.2
GND: IC1.11 (V-), R1.1, R4.1, RF_1.2
unnamed: IC1.10 (+IN), RB_1.2, RF_1.1
unnamed: IC1.5 (+IN), R3.1, R4.2
unnamed: IC1.6 (-IN), IC1.7 (OUT), RB_2.1
unnamed: IC1.1 (OUT), IC1.2 (-IN), RB_1.1
unnamed: IC1.9 (-IN), RB_2.2, RF_2.1
unnamed: IC1.8 (OUT), RF_2.2
V1: FLEX_IN.1, IC1.3 (+IN), R1.2

Notes on the sheet:
2.2" Flex Sensor
