SleepWorkers/Project-SIGHT/test/avneesh_test_files/TI_CC3220SF_WiFi_MCU/Energia_examples/Blinks/Blinks.ino

/*
 * Blinks
 * 
 * Author: Avneesh Mishra
 * Basic example to show the RED, YELLOW and GREEN LEDs blink in order
 * 
 * Hardware Required:
 *     - LaunchPad with RED, YELLOW and GREEN LEDs
 * We've used the CC3220SF LAUNCHXL
 * 
 */

// Define Red, Yellow and Green as LED variables
#define P64 29
#define P01 9
#define P02 10
#define LED1 P64
#define LED2 P01
#define LED3 P02

void setup() {
  // Set all the LEDs as OUTPUT type
  pinMode(LED1, OUTPUT);
  pinMode(LED2, OUTPUT);
  pinMode(LED3, OUTPUT);
  // Setup the serial to 115200 baud rate
  Serial.begin(115200);
}

void loop() {
  // Turn ON only LED1 and notify on serial
  digitalWrite(LED1, HIGH);
  digitalWrite(LED2, LOW);
  digitalWrite(LED3, LOW);
  Serial.println("LED1 is ON");
  delay(1000);
  // Turn ON only LED2
  digitalWrite(LED1, LOW);
  digitalWrite(LED2, HIGH);
  digitalWrite(LED3, LOW);
  Serial.println("LED2 is ON");
  delay(1000);
  // Turn ON only LED3
  digitalWrite(LED1, LOW);
  digitalWrite(LED2, LOW);
  digitalWrite(LED3, HIGH);
  Serial.println("LED3 is ON");
  delay(1000);
}
