SleepWorkers/Project-SIGHT/test/avneesh_test_phase1/arduino_test_files/Flex_Analog_Debug_Print/Flex_Analog_Debug_Print.ino

/*
 * Connect sensor to A0 analog input pin
 * Open serial monitor or serial plotter to monitor the value
 */
void setup() {
  // put your setup code here, to run once:
  Serial.begin(115200);
}

void loop() {
  // put your main code here, to run repeatedly:
  Serial.println(analogRead(A0));
  delay(250);
}
