SleepWorkers/Project-SIGHT/(commit log)

2019-01-03 Reverted to an initial stage, trial
2019-01-10 Added analog flex sensor and serial interface
    [Flex_Analog_Debug_Print.ino]
2019-01-17 Pulse sensor arduino test [IGNORE]
2019-02-05 Added modifications to resistance values, issue #16
2019-02-07 Added tests for version 2, final circuitry done. Progress on issue #16
2019-02-07 Added script file (resistance finder), issue #16
2019-02-08 Added Eagle CAD files for version 1, issue #16
    [FlexSensor_2in2.sch]
2019-02-15 Added files for second version Flex sensor debug
2019-02-16 Added CAD files for issue #16, solves and closes #16
    [Final_circuitry_v1.sch, Simple_2in2_flex.sch, Simple_4in5_flex.sch]
2019-02-21 Added Digital output and Serial code "Blinks", issue #21
    [Blinks.ino]
2019-02-23 Tried out new values of resistors (hardware test failure), issue #22
2019-02-23 Added Arduino codes for issue #22
    [Analog_val_lock.ino, Full_code.ino, LED_voltage_generator.ino]
2019-02-23 Added Eagle CAD files for issue #22
    [LED_connections.sch, single_4in5_flex_5led.sch]
2019-02-24 Added MATLAB backup files in MATLAB_scripts, issue #21
    [Final_code.ino]
2019-03-03 Added GPIO digital I/O and interrupts for issue #29
    [BIOS.obj, m3_Hwi_asm.obj, m3_Hwi_asm_switch.obj, m3_IntrinsicsSupport_asm.obj, m3_TaskSupport_asm.obj, release.cfg]
2019-03-04 Added PWM CCSv8 example codes for issue #29
    [BIOS.obj, m3_Hwi_asm.obj, m3_Hwi_asm_switch.obj, m3_IntrinsicsSupport_asm.obj, m3_TaskSupport_asm.obj, release.cfg]
2019-03-06 Added example code for ADCs and UART along with documentation for issue #29
    [BIOS.obj, m3_Hwi_asm.obj, m3_Hwi_asm_switch.obj, m3_IntrinsicsSupport_asm.obj, m3_TaskSupport_asm.obj, release.cfg]
2019-03-07 Added TI CCS files for issue #21
    [BIOS.obj, m3_Hwi_asm.obj, m3_Hwi_asm_switch.obj, m3_IntrinsicsSupport_asm.obj, m3_TaskSupport_asm.obj, release.cfg]
2019-03-09 Added CAD files, closes issue #31
    [Final_circuit.sch, flex_sensor_wheatstone.sch, flex_sensors_two_types.sch, instrumentation_amplifier.sch]
2019-03-10 Converted existing file to v1
    [LED_connections.sch, single_4in5_flex_5led.sch]
2019-03-11 Added serial side code for #33
    [BIOS.obj, m3_Hwi_asm.obj, m3_Hwi_asm_switch.obj, m3_IntrinsicsSupport_asm.obj, m3_TaskSupport_asm.obj, release.cfg]
2019-03-11 Added cv_bridge, issue #33 solved
    [BIOS.obj, m3_Hwi_asm.obj, m3_Hwi_asm_switch.obj, m3_IntrinsicsSupport_asm.obj, m3_TaskSupport_asm.obj, release.cfg]
2019-03-15 Added Flex sensor eagle files
2019-03-15 Added Eagle files for flex sensor
    [Instrumentation_amplifier_CC2640R2.sch, Instrumentation_amplifier_CC3220SF.sch, Instrumentation_amplifier_MSP430FR2355.sch, Wheatstone_bridge.sch]
2019-03-16 Added code for I2C test
    [BIOS.obj, m3_Hwi_asm.obj, m3_Hwi_asm_switch.obj, m3_IntrinsicsSupport_asm.obj, m3_TaskSupport_asm.obj, release.cfg]
2019-03-16 Flex sensor circuitry update, issue #15
    [Instrumentation_amplifier_CC3220SF.sch]
2019-03-17 Modification 1
    [Wheatstone_bridge.sch]
2019-03-19 Updated flex sensor circuitry for new flex sensor
    [Wheatstone_bridge.sch]
2019-03-19 Added Intrumentation amplifier CAD file
2019-03-19 Board created for Wheatstone bridge side
    [Wheatstone_bridge.brd, Wheatstone_bridge.sch]
2019-03-19 Added isntrumentation amplifier CAD files and board files
    [Instrumentation_amplifier_CC3220SF.brd, Instrumentation_amplifier_CC3220SF.sch]
2019-03-20 Made changes to the CAD files
    [Instrumentation_amplifier_CC3220SF.brd, Wheatstone_bridge.brd]
